francoriba/self_balancing_bot/README.md

# Robot Autobalanceado de Dos Ruedas
Trabajo práctico final de sistemas de control 1 - FCEFyN, UNC - Robot Autobalanceado
Videos y fotos del proyecto: https://drive.google.com/drive/folders/1bMKZYu2w7RBSlc7AJ7NAG8CdF2A5MKAy?usp=sharing
