francoriba/self_balancing_bot/v2.4.0_robot_riba.pdf

# Universidad Nacional de Córdoba Facultad de Ciencias Exactas, Físicas y Naturales Córdoba, Argentina

# Trabajo Integrador de Sistemas de Control 1

# ROBOT DE DOS RUEDAS AUTOBALENCEADO

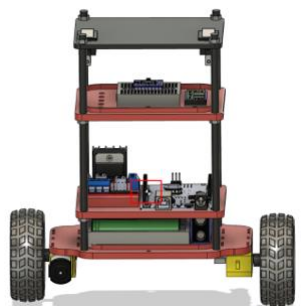
[picture p1: figure]

### Autor: Riba, Franco Docentes: Ing. Claudio Agüero – Ing. Reinado Reyes Contacto: franco.riba@mi.unc.edu.ar Año de cursado de la asignatura: 2021

## ÍNDICE

### Acceso a recursos:

### Repositorio en GitHub del proyecto (código Arduino + simulaciones): https://github.com/francoriba/sisControl/tree/master

Videos | y | fotos | de | la | evolución | del | proyecto:

### https://drive.google.com/drive/folders/1bMKZYu2w7RBSlc7AJ7NAG8CdF2A5MKAy?usp=sh

aring (https://drive.google.com/drive/folders/1bMKZYu2w7RBSlc7AJ7NAG8CdF2A5MKAy?usp=sharing)

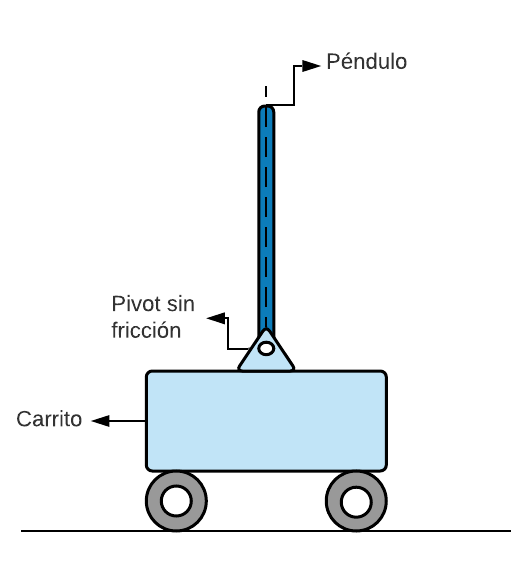
[picture p2: figure]
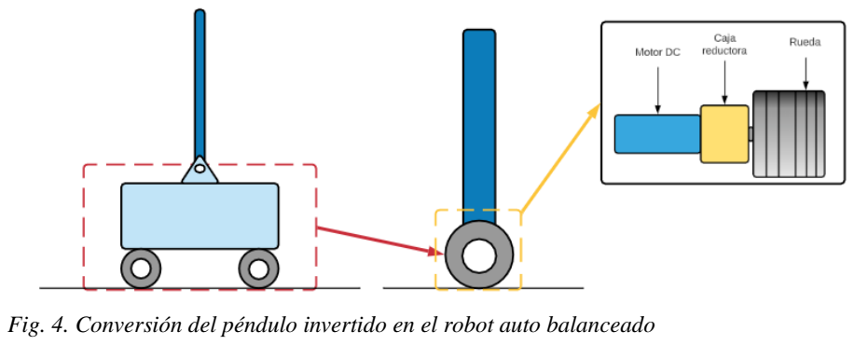
[picture p3: figure]

Córdoba, Argentina, 2022

### 1. Introducción

El robot de dos ruedas auto balanceado consiste en plataforma robótica con dos ruedas que actúan independientemente y un centro de masa que se encuentra sobre el eje de rotación de las ruedas. Este tipo de robots han tenido un rápido avance en la última década y aparecieron en múltiples áreas de la vida cotidiana de las personas. Los ejemplos más notables que hacen uso de los mismos principios son los vehículos de transporte urbano como pueden ser los llamados Segway o los Hoverboards, sin embargo, se pueden hallar multitud de aplicaciones en distintos campos, como los dispositivos de transporte de equipajes, robots de asistencia y sillas de ruedas. Se trata de un proyecto no muy sencillo que engloba la mayoría de los conceptos aprendidos en la materia Sistemas de Control 1 y que da lugar a poner en práctica nuestras capacidades de diseño y programación.

### 2. Definición del Problema

### 2.1 Principio de Funcionamiento

Este sistema basa su funcionamiento en el mismo principio que rige el balanceo del clásico sistema de péndulo invertido con carrito motorizado mostrado en la Fig. 1. En este sistema cuando el péndulo cae hacia adelante el carrito avanza al frente para volver al estado de equilibro como se muestra en la Fig. 2., por el contrario, cuando el péndulo cae hacia atrás, el carrito retrocede con el mismo objetivo como se indica en la Fig. 3.

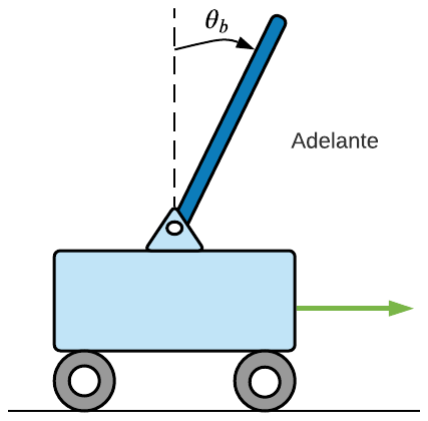
[picture p4: figure]
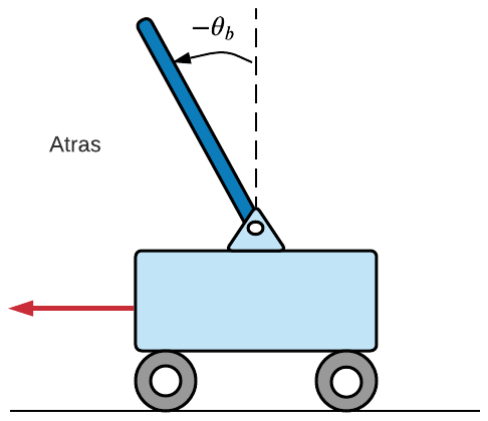
[picture p5: figure]

Podemos transformar fácilmente este sistema en el de del robot auto balanceado reemplazando el carrito por dos motorreductores con escobillas cuyos ejes de salida pasarán a ser pivotes entre las ruedas y el chasis (péndulo).

Fig. 4. Conversión del péndulo invertido en el robot auto balanceado

Fig. 3. Péndulo invertido | Fig. 2. Péndulo invertido en equilibrio
inclinado hacia adelante y
acción restauradora

Fig. 1. Péndulo invertido hacia atrás y acción restauradora

### 2.2 Conceptos Teóricos de Sistemas de Control

Este apartado está dedicado a relacionar y asociar conceptos teóricos básicos de Sistemas de Control con nuestro sistema de estudio.

### 2.2.1 Bloques del Sistema

- Detector de error: implementado vía software mediante placa de desarrollo Arduino UNO.
- Controlador: utilizaremos un controlador digital, concretamente la placa de desarrollo Arduino UNO, a nivel de software el controlador contará con un algoritmo de control PID.
- Amplificador: modulo controlador para motores, doble puente H - L298N.
- Actuador o Accionador: motorreductores genéricos de robótica.
- Planta o Proceso: dinámica del robot autobalenceado propiamente dicho, formado por lo que más adelante en este informe llamaremos Cuerpo Principal y Sistema de Rotación.
- Unidad de realimentación o Captador: sensor tipo IMU (Unidad de Medición Inercial), concretamente el módulo MPU 6050 de 6 ejes que integra un acelerómetro (mide aceleración lineal en 3 ejes), un giroscopio (mide velocidad angular en 3 ejes) y un DMP (Procesador de movimiento digital que permite obtener la fusión de los datos del acelerómetro y del giroscopio independientemente del microcontrolador)

En el anexo podrá encontrar el detalle del hardware utilizado donde se explica con mayor detalle el funcionamiento, características y otros aspectos a considerar de los componentes utilizados.

### 2.2.2 Señales del Sistema y sus Niveles

- Señal de mando o entrada: ángulo de inclinación θbset [°] deseado para el robot. Este parámetro se configura vía software en el microcontrolador.
- Señal controlada o salida: rigurosamente se tienen dos señales de salida, la velocidad angular θ̇
b [

°
seg

]

del chasis del robot (que captará el giroscopio) y aceleración lineal a[

m
s

2

] (que captará el

acelerómetro). Sin embargo, para simplificar el análisis consideraremos directamente al ángulo de inclinación del chasis del robot θb[°]como única señal de salida ya que es esto lo que deseamos controlar.
- Señal de error: diferencia entre el ángulo de inclinación deseado y el ángulo de inclinación calculado por procesador de movimiento digital del MPU6050, esto es e(t) = θbset − θb

(t) [°].
- Señal de control: tensión va

(t)[V] que el amplificador aplica a los motorreductores (señal de alta potencia generada por el driver) en función del ancho de pulso de la señal PWM de 8 bits (señal de baja potencia generada por el controlador) comandada por el algoritmo de compensación PID a implementar en el microcontrolador.
- Señal realimentada: ángulo de inclinación θb(t) detectado (en verdad calculada a partir de los valores de velocidad y aceleración sensados) por el sensor.

NOTA: ver diagrama de bloques del sistema al final del anexo del informe.

### 2.2.3 Posibles Perturbaciones

Las perturbaciones más frecuentes a la que será sometido el sistema son por un lado la propia gravedad y por el otro el dedo humano ya que una vez se tenga el robot funcionando podremos examinar sus limitaciones obstaculizando su funcionamiento en distintos niveles. Otra perturbación de la misma naturaleza podría originarse cuando el robot impacte contra algún objeto ya que no estaremos incorporando al robot un sistema de detección de obstáculos, sin embargo, esto sería posible utilizando sensores ultrasónicos o infrarrojos, aunque quedará pendiente como posible mejora futura del proyecto.

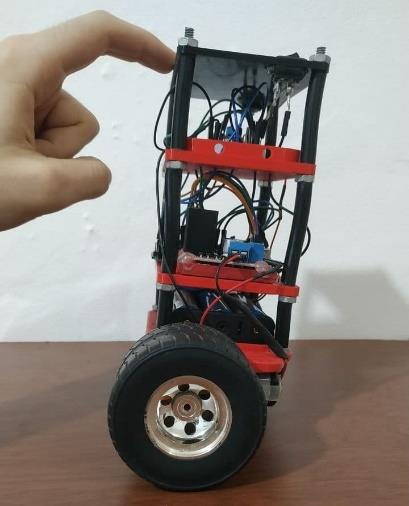
[picture p6: figure]

Otras perturbaciones no tan intuitivas que pueden presentarse podrían ser aquellas relacionadas a la presencia de error y demoras en la estimación de la variable de salida debido a la forma de operación de los sensores y la presencia de ruido. La eficiencia de los algoritmos utilizados también es un aspecto para considerar ya que comúnmente la etapa de censado y realimentación requiere filtros Kalman o filtros complementarios para la obtención de θi

(t), es por esta
razón que para esta tarea se ha optado por utilizar el algoritmo de fusión del DMP integrado al MPU 6050 ya que este utiliza técnicas estadísticas y trabaja con cuaterniones (una extensión de los números reales similar a los números complejos).

### 2.2.4 No Linealidades Involucradas

- Fuerzas de fricción no lineales en el motor y la caja reductora.
- Efectos de saturación en el circuito del controlador L298N que puedan producirse cal alcanzar la máxima corriente permitida.
- No linealidades propias del modelado matemático del cuerpo principal (desarrollado en sección 3.5)

### 3. Modelado Matemático de la Planta

El objetivo final de esta sección es la obtención de la función de transferencia de la planta. Debemos aclarar que basándonos en [https://en.wikipedia.org/wiki/Plant_(control_theory)] en este trabajo se considerará que la planta contempla dos elementos, el primero es el “Actuador” representado por el motorreductor y el segundo es el “Proceso” que para nuestro sistema podría considerarse representado por el conjunto chasis-ruedas. Esto puede diferir de lo indicado en ciertas bibliografías que consideran como elementos separados a los actuadores y a la planta, lo cierto es que en nuestro robot los motorreductores se encuentran rígidamente enlazados al chasis y las ruedas, es por ello por lo que resulta conveniente considerar la planta como sistema que combina los elementos motorreductor, chasis y rueda. Dado que el motorreductor funciona como nexo entre el chasis y las ruedas proponemos dividir la planta en dos subsistemas acoplables entre sí, los subsistemas que proponemos son:

- Cuerpo Principal: este subsistema se asemeja funcionalmente al péndulo en el sistema de péndulo invertido con carrito. Los elementos que incluye son:
✓ | Chasis (plataformas con los componentes y varillas)
✓ | Estator
✓ | Rodamientos/bujes/rulemanes/bolilleros del eje del motor
✓ | Carcasa de motorreductor
- Sistema de Rotación: este subsistema se asemeja al carrito en el sistema de péndulo invertido con carrito. Los elementos que incluye el Sistema de Rotación son:
✓ | Rueda
✓ | Rotor del motor eléctrico
✓ | Engranajes de la caja reductora
✓ | Eje de salida de la caja reductora

La figura representa la división de partes planteada para el robot:

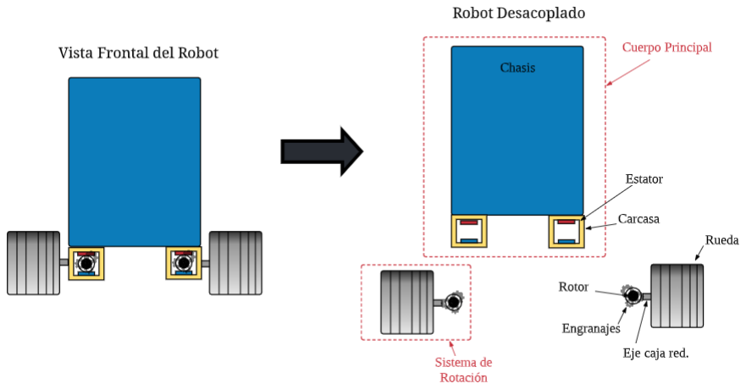
[picture p7: figure]

### 3.1 Consideraciones Previas

En esta sección se dejan en claro todos los detalles que el lector debería tener en consideración antes de iniciar de lleno en la lectura sobre la obtención de las ecuaciones de movimiento del sistema.

### 3.1.1 Nomenclatura Básica Utilizada

Para estudiar el movimiento del robot tendremos que trabajar con diversas variables, algunas de ellas describirán el movimiento de las ruedas (analogía con el carrito según la Fig. 4) mientras que otras describirán el movimiento del chasis (analogía con el péndulo según la Fig. 4), es por ello por lo que en la Tabla 1 establecemos la nomenclatura de estas variables y en la tabla debajo indicamos sus unidades en el sistema internacional junto con una breve descripción del aspecto físico que representa cada una de ellas.

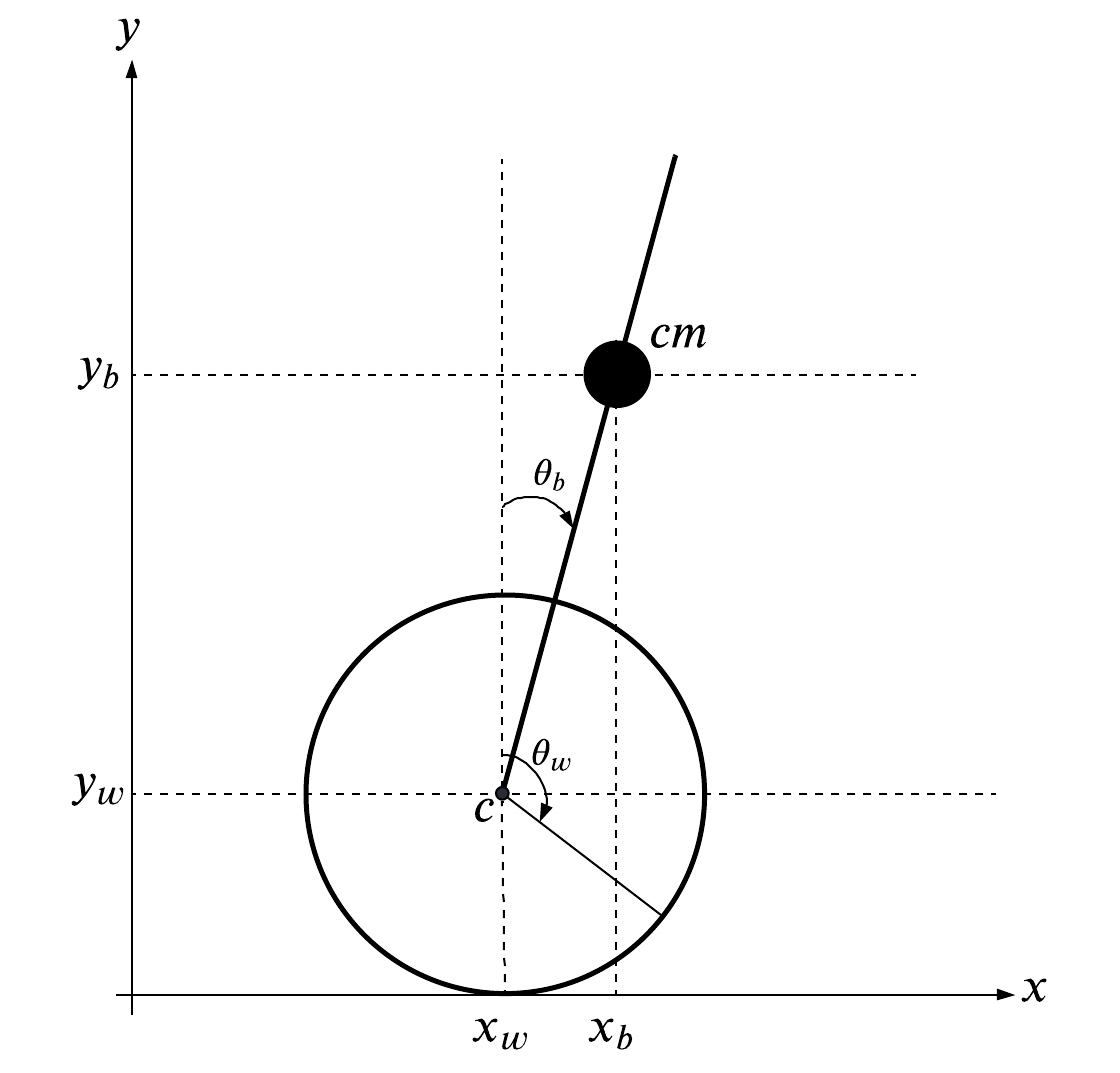
[picture p8: figure]

Símbolo | Unidad | Descripción
θb | θ̇ b | θ̈ b | rad | rad s | rad 2 s | Desplazamiento / Velocidad / Aceleración angular del cuerpo principal
θw | θ̇w | θ̈w | | | | Desplazamiento / Velocidad / Aceleración angular del sistema de rotación
xb | ẋb | ẍb | m | m s | m 2 s | Desplazamiento / Velocidad / Aceleración lineal del centro de masa del cuerpo principal en la dirección x
yb | ẏb | ÿb | | | | Desplazamiento / Velocidad / Aceleración lineal del centro de masa del cuerpo principal en la dirección y
xw | ẋw | ẍw | | | | Desplazamiento / Velocidad / Aceleración lineal del centro de la rueda en la dirección x
yw | ẏw | ÿw | | | | Desplazamiento / Velocidad / Aceleración lineal del centro de la rueda en la dirección y

Tabla 1: Unidades y descripción de las variables que describen el movimiento del Robot

### 3.1.2 Parámetros del Robot

En la figura se indican los distintos parámetros del robot, donde podemos distinguir entre los que son propios del chasis y los que son propios de la rueda.

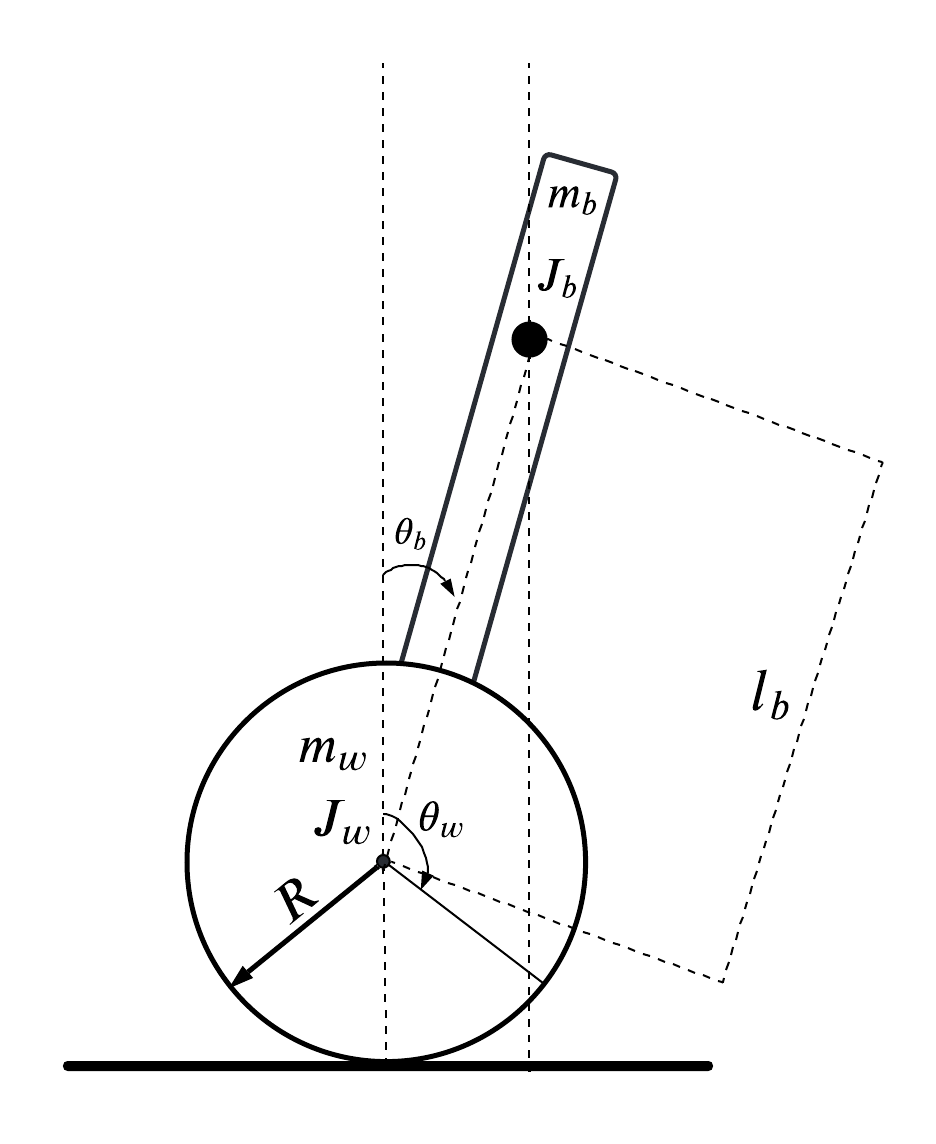
[picture p9: figure]

### 3.1.3 Sistema de Coordenadas Utilizado

A la hora analizar la dinámica del chasis y de las ruedas será útil tener definido un sistema de coordenadas que permita avanzar en el desarrollo de las ecuaciones. La siguiente imagen muestra el análisis realizado al conjunto chasis – ruedas mediante reglas trigonométricas básicas aplicables con la regla SOHCAHTOA, es decir realizando una asociación del sistema del robot con el círculo unitario, esto nos permitirá trabajar con coordenadas polares.

Símb | Uds. | Descripción
mb | Kg | Masa del cuerpo principal
Jb | Kg m² | Momento inercial del cuerpo principal
mw | Kg | Masa del sistema de rotación
Jw | Kg m² | Momento inercial del sistema de rotación
R | m | Radio de la rueda
lb | m | Distancia entre el centro de la rueda y el centro de masa del chasis

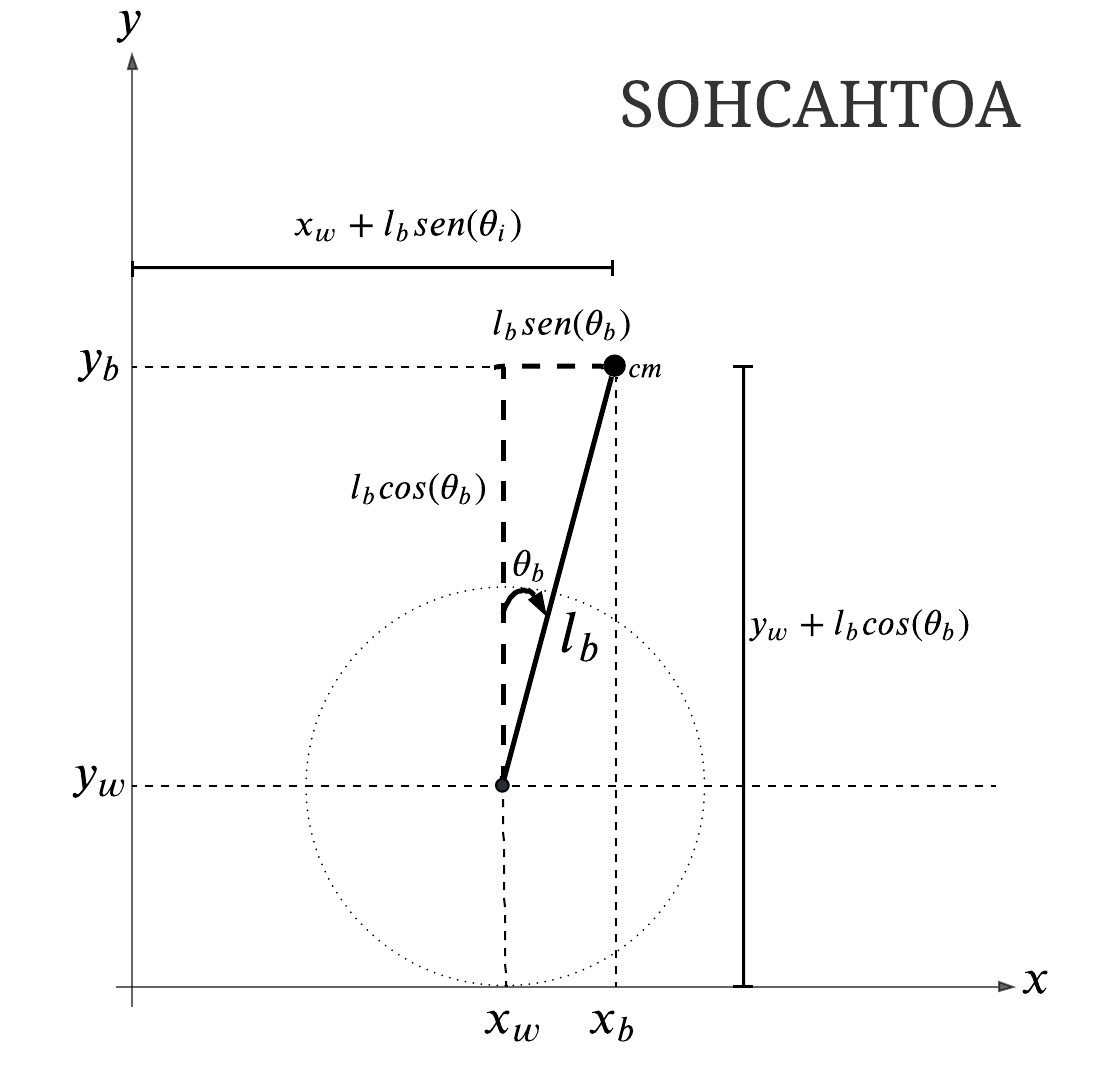
[picture p10: figure]

En base a este análisis podemos observar que el desplazamiento lineal del chasis referenciado a su centro de masa tiene coordenadas cm = (xb, yb) con:

xb = xw + lb sin(θb) | (1)
yb = yw + lb cos (θb) | (2)

Donde xw representa la coordenada en la dirección x del centro de la rueda e yw representa la coordenada en la dirección y de la rueda.

Aplicando las reglas de derivación para el producto de funciones y la regla de la cadena a (1) y (2) obtenemos:

{

ẋb = ẋw + θ̇
blb cos(θb

)
ẍb = ẍw +θ̈
blb cos(θb

)−θ̇
b

2
lb sen(θb

)
ẏb = ẏw − θ̇
blb sen(θb

) = −θ̇
blb sen(θb

)
ÿb = −θ̈
blb sen(θb

)−θ̇
b

2
lb cos(θb

)

(3)

### 3.2 Dinámica del Sistema de Rotación

Recordemos que cuando hablamos de sistema de rotación nos referimos al conjunto rueda-rotor-engranajes-eje.
Para el modelado se asumen las siguientes condiciones:
1. Ambas ruedas son idénticas.
2. Las ruedas son rígidas y de masa uniformemente distribuida.
3. Las ruedas giran sin deslizar.
4. La superficie en que se mueve el robot es plana y horizontal, cumpliéndose que ẏw = 0

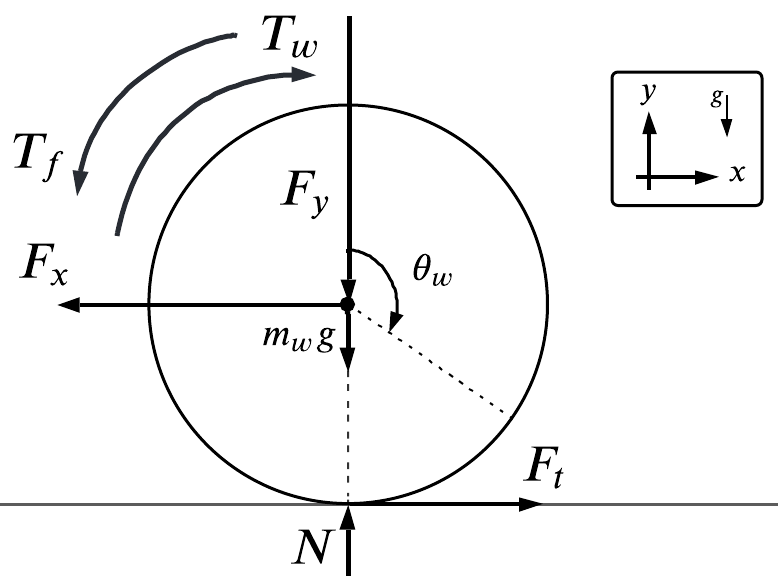
[picture p11: figure]

Como hemos ya hemos establecido al inicio se asume una superficie plana y horizontal de forma que ẏw = 0 y en consecuencia ÿw = 0, teniendo esto en cuenta podemos aplicar la segunda ley de movimiento de Newton a las fuerzas en la dirección y (i.e. ∑ Fy

⃗⃗ = mwÿw) tomando como referencia la Tabla 1:

N − mwg −Fy = mwÿw = 0 | (4)

Haciendo uso de la segunda ley de movimiento de Newton para las fuerzas en la dirección x (i.e. ∑ Fx

⃗ = mwẍ), se
obtiene:
Ft −Fx = mwẍw | (5)

Haciendo uso de la misma ley aplicada a la rotación (i.e. ∑ Mo = Jwθ̈w) ,se obtiene:

Tw − RFt = Jwθ̈w | (6)

Dado que se ha asumido que la rueda gira sin deslizar resulta válido plantear:

xw = θwR → θw =

xw
R

→ θ̈w =

ẍw
R

(7)

Si ahora se despeja Ft de (5) y se la remplaza junto a (7) en (6) se obtiene la expresión:

ẍw (Jw

1
R² + mw ) =

1
R
Tw − Fx | (8)

Esta ecuación nos resultará útil mas adelante.

Símb | Uds. | Descripción
Fx | N | Fuerza horizontal rueda-chasis
Fy | N | Fuerza vertical rueda-chasis
Ft | N | Fuerza de tracción (rozamiento)
mwg | N | Peso del sistema de rotación
N | N | Fuerza normal a la superficie
Tw | N m | Torque aplicado a la rueda
Tf | N m | Torque de fricción (despreciado)

### 3.3 Dinámica del Cuerpo Principal

Hay que recordar que cuando hablamos de cuerpo principal nos referimos al conjunto chasis-estator-carcasa. Para simplificar el modelado se asume que el peso se encuentra uniformemente distribuido.

La única diferencia con las fuerzas externas de la rueda es la ausencia de fuerza de tracción Ft
, esto es debido
a que el eje del motorreductor solo impulsa a la rueda, no al chasis.

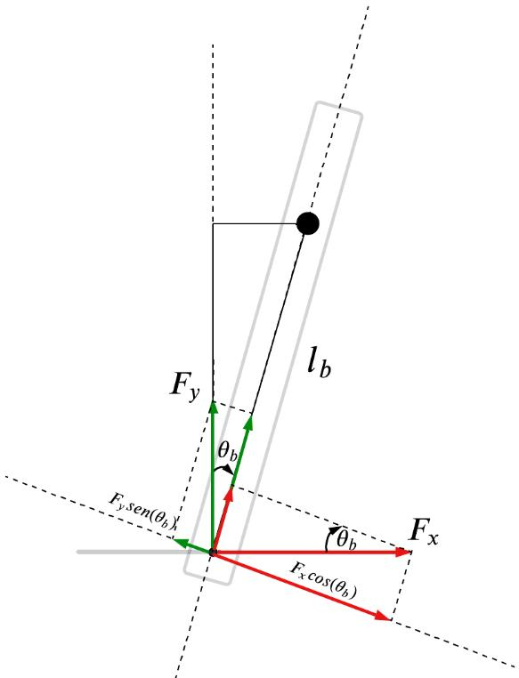
[picture p12: figure]
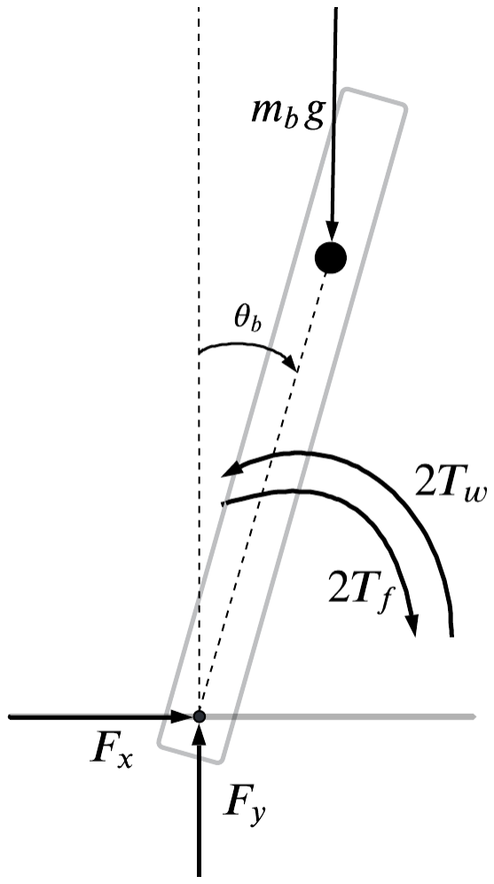
[picture p13: figure]

Consideraremos al giro en sentido horario como negativo y al giro en sentido anti-horario como positivo.

Haciendo uso de la segunda ley de movimiento de Newton en la dirección x (i.e. ∑ Fx

⃗ = mbẍb) , se obtiene:

Fx = mbẍb | (9)

Según los resultados de (3) podemos expresar (9) como:

Fx = mb [ẍw +θ̈
blb cos(θb

)−θ̇
b

2
lb sen(θb
)] | (10)

Haciendo uso de la segunda ley de movimiento de Newton en la dirección y (i.e. ∑ Fy

⃗⃗ = mbÿG) , se obtiene:

Fy − mbg = mbÿb | (11)

Según los resultados de (3) podemos expresar (11) como:

Fy = mbg − mb [θ̈
blb sen(θb

) + θ̇
b

2
lb cos(θb
)] | (12)

Haciendo uso de la segunda ley de movimiento de Newton aplicada a la rotación del centro de masas del chasis (i.e. ∑ Mcm = Jbθ̈
b) ,y teniendo en cuenta la descomposición de fuerzas presentada en 3.3 tenemos que:

−2Tw + Fylb sin(θb

)− Fxlb cos(θb

) = Jbθ̈
b | (13)

### 3.4 Obtención de las Ecuaciones de Movimiento

Sustituyendo (10) y (12) en (13) se obtiene la primer ecuación de movimiento para el conjunto rueda-chasis:

(Jb + mblb

2
)θ̈
b = mbg lb sen(θb

)− mblb cos(θb

) ẍw − 2Tw | (14)

Mientras que si sustituimos (10) en (8) btenemos la segunda ecuación de movimiento para el conjunto rueda-chasis:

[mb +2 (

Jw
R² + mw )] ẍw = −mblb cos(θb ) θ̈
b + mblb sen(θb

) θ̇
b

2
+

2Tw
R | (15)

### 3.5 Linealización de las Ecuaciones de Movimiento

Observando las ecuaciones de movimiento obtenidas podemos darnos cuenta de que no son lineales debido a la presencia de funciones seno, coseno y exponentes cuadráticos. Como ya sabemos, en la asignatura de Sistemas de Control nos hemos enfocado exclusivamente en el estudio de sistemas lineales e invariantes en el tiempo (LTI), por lo que un sistema no lineal necesitará ser linealizado para que podamos avanzar con su estudio. La clave para linealizar nuestras ecuaciones de movimiento es identificar en qué punto el sistema se encuentra en equilibrio ya que en torno a dicho punto existirá una región de operación en la cual puede establecerse una aproximación como sistema lineal de nuestro sistema no lineal.

Resulta intuitivo pensar que el robot se caerá si no es inicialmente colocado en una posición cercana al punto de equilibrio, esto significa que bajo funcionamiento normal el robot deberá encontrarse en una posición aproximadamente vertical respecto de la superficie de apoyo y el movimiento de rotación a lo largo del eje de la rueda será θb ≈ 0 rad, entonces este será el punto de operación que utilizaremos para linealizar nuestro sistema.

Los términos de las ecuaciones de movimientos que deberemos linealizar son sen(θb

), ẍwcos(θb

), θ̈
bcos (θb) y
θ̇
b

2
sen(θb

), para linealizarlos utilizaremos el método de expansión en serie de Taylor considerando el primer término de esta y considerando el punto de operación ya indicado (i.e. punto de operación θi = 0 rad ).

sen(θb

) ≈ θb

ẍwcos(θb

) ≈ ẍw

θ̈
b cos(θb

) ≈ θ̈
b

θ̇
b

2
≈ 0

(16)

Sustituyendo lo planteado en (16) en (14) y (15) obtenemos las ecuaciones de movimiento linealizadas:

(Jb + mblb

2
)θ̈
b = mbg lbθb − mblbẍw −2Tw | (17)

[mb + 2 (

Jw
R² + mw )] ẍw = −mblbθ̈
b +

2Tw
R | (18)

Notar que se han linealizado las ecuaciones de manera previa a combinar las ecuaciones de la dinámica del sistema de rotación y el cuerpo principal con las ecuaciones de la dinámica del actuador, la razón por la que podemos hacer esto es porque de antemano sabemos utilizaremos un modelo lineal del motor, es decir que las ecuaciones que describen su comportamiento no requerirán la linealización de algunos de sus términos.

Las ecuaciones (17) y (18) pueden ser reescritas con el fin de expresarlas en el formato de espacio de estados, para eso sustituimos θ̈
b de (17) en (18) y ẍw de (18) en (17)(14) al hacer esto y reordenar las expresiones resultantes se obtiene:

ẍw =

1

mb+2(

Jw
R2+mw )−

(mblb

)

2

Jb+mblb

2

{−

(mblb)

2g

Jb+mblb

2 θb + 2 [

1
R

+

mblb
Jb+mblb

2

] Tw}

(19)

θ̈
b =

1

Jb+mblb

2−

(mblb

)

2

mb+2(

Jw
R2

+mw )

{mblbgθb − 2 [R +
mblb
mb+2(

Jw
R2+mw )

]
Tw
R

}

(20)

Definiendo las constantes:

M ≡ mb + 2 (

Jw
R² + mw ) −

(mblb)

2

Jb+mblb

2

J ≡ Jb + mblb

2 −

(mblb)

2
mb+2(

Jw
R2+mw )

C1 ≡ −

1
M

(mblb)

2g

Jb+mblb

2

C2 ≡

2
M

[

mblb
Jb+mblb

2 +

1
R

]

C3 ≡

1
J

mb lbg

C4 ≡ −

2

RJ (
mblb
mb+2(

Jw
R2+mw )

+ R)

(21)

Las ecuaciones (19) y (20) pueden ser expresadas como:

ẍw = C1θb + C2Tw

θ̈
b = C3θb + C4Tw

(22)

### 3.6 Dinámica del Actuador

Los actuadores que se implementarán en el sistema son motorreductores, es decir motores DC con escobillas a los cuales se les adiciona una caja reductora con engranajes que permiten aumentar la cantidad de toque producido por el motor a costa de una disminución proporcional de la velocidad de giro del eje de salida de la caja reductora respecto de la velocidad de giro del eje motor. En la siguiente imagen se indican las partes básicas por las que se encuentra formado un motorreductor.

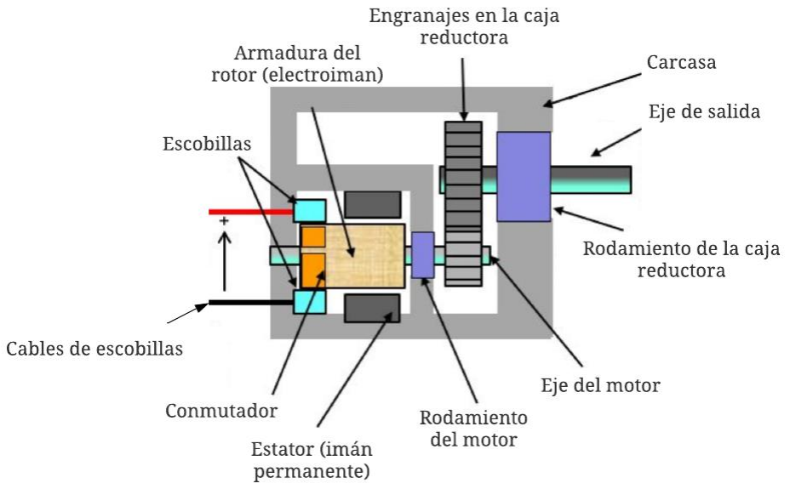
[picture p14: figure]

Antes de comenzar con el modelado del motorreductor se presenta la tabla, la cual indica la simbología que se utilizará para representar los parámetros del motorreductor, así como también indicará las unidades en el sistema internacional y una breve descripción de dichos parámetros.

Símb | Uds. | Descripción
θm | rad | Posición angular del eje del motor
θ̇m | rad/s | Velocidad angular del eje del motor
bf | Nms/rad | Coeficiente de amortiguamiento viscoso del rotor (despreciado)
n | - | Relación de transmisión
Tm | Nm | Torque producido por el motor
va | V | Voltaje de entrada del motor
vemf | V | Voltaje de contra fuerza electromotriz
ia | A | Corriente en la armadura del rotor
Ra | Ω | Resistencia del motor
La | H | Inductancia de la armadura (despreciada)
ke | Vseg/rad | Constante de contra fuerza electromotriz de la armadura
kt | Nm/A | Constante de torque del motor

Para el modelado del motor DC nos resulta de utilidad trabajar con el circuito eléctrico equivalente del rotor que se muestra en la imagen a continuación. El circuito equivalente de las bobinas en el rotor es representado por la conexión en serie de Ra y La. Ra representa la perdida resistiva en la bobina mientras que La representa la autoinductancia del bobinado (el bobinado genera su propio campo magnético cuando se aplica tensión en los terminales del motor, por ello se comporta como un inductor). Cuando se aplica el voltaje vm entre los terminales del motor, la corriente im fluye hacia el bobinado del rotor, entonces este se convierte en un electroimán e interactúa con los imanes permanentes en el estator para impulsar el rotor en sentido horario o antihorario. Los parámetros kt y ke son coeficientes que dependen de la construcción del motor DC.

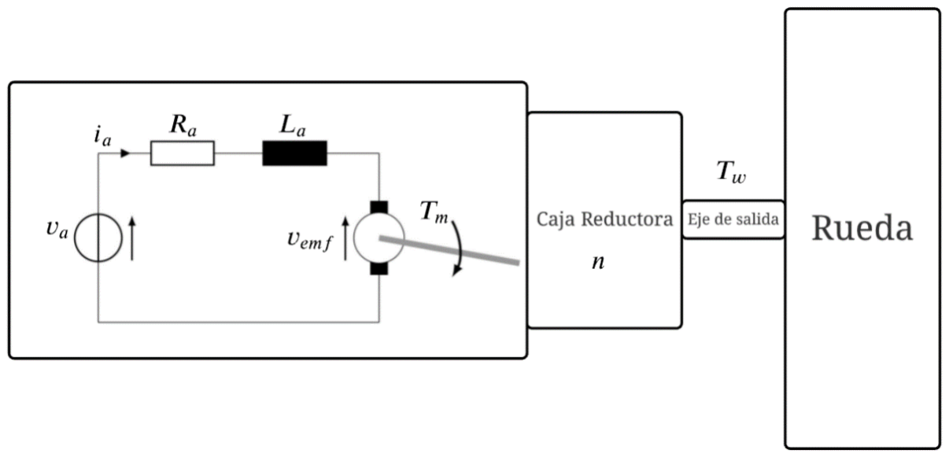
[picture p15: figure]

Se considera el circuito de la armadura en esta imagen, donde el torque generado en el rotor (y posteriormente amplificado por la caja de transmisión y presentado en el eje de salida) es proporcional a la intensidad del campo magnético de la bobina del rotor que a su vez depende de la corriente ia que fluye por la bobina (Ley de Biot-Savart de magnetostática). Este conjunto de relaciones se puede plasmar matemáticamente por medio de la fórmula:

Tm = kt

ia | (23)

Otra relación de los motores DC es la que indica que la tensión de contra fuerza electromotriz dependerá de que tan rápido el rotor gire en torno al estator:

vemf = keθ̇m | (24)

Aplicando la ley de tensiones de Kirchoff al circuito de la armadura se tiene:

va = Raia +

d ia
dt La + vemf | (25)

Sin embargo, la inductancia del motor Lm se considera nula, esto se debe a que cuando el motor se encuentra en reposo la bobina se ha descargado completamente a través del circuito cerrado posteriormente a la anterior marcha del motor. Otra razón para considerar despreciable Lm es que generalmente su valor es muy pequeño comparado con el valor resistivo de Rm. Entonces tenemos que

va ≅ Raia + vemf | (26)

Sustituyendo (24) en (26):

va ≅ Raia + keθ̇m | (27)

Despejando ia de (27) se tiene:

ia ≅

va
Ra

−

keθ̇m
Ra

(28)

Teniendo en cuenta que hemos asumido bf = 0 se cumplen las siguientes relaciones debidas a la presencia de la caja reductora entre la rueda y el motor

Tw = nTm → Tm =

Tw
n | (29)
θm = nθw | (30)

Si ahora sustituimos (28) en (23):

Tm =

kt
Ra

va −

ktke
Ra
θ̇m | (31)

Sustituyendo (29) en (31):

Tw =

nkt
Ra

va −

nktke
Ra

θ̇m
(32)

La ecuación (32) es válida si se asume que la carcasa del motor se encuentra en reposo, sin embargo los motorreductores estan rigidamente fijos al chasis, y θm es el ángulo relativo entre el eje del motor (o rotor) y el estator, por lo tanto deberemos considerar este detalle realizando la modificación θ̇m → (θ̇m −θ̇
b) en (32), de forma que
resulta:

Tw =

nkt
Ra

va−

nktke
Ra

θ̇m +

nktke
Ra

θ̇
b | (33)

Finalmente, si recordamos (7), podemos reemplazar θ̇m por

ẋw
Rn

resultando:

Tw =

nkt
Ra

va −

ktke
RaR

ẋw+

nktke
Ra

θ̇
b | (34)

Y definimos las siguientes constantes del motor:

Cm1 ≡

nkt
Ra
Cm2 ≡ −

ktke
RaR
Cm3 =

nktke
Ra

(35)

De forma que podemos expresar (34) como

Tw = Cm1va + Cm2ẋw + Cm3θ̇
b

(36)

### 3.7 Incorporación de la Dinámica del Actuador a las EDM

Sustituyendo (36) en las expresiones de (22) obtenemos:

ẍw = C1θb + C2Cm1va +C2Cm2ẋw + C2Cm3θ̇
b

θ̈

b = C3θb + C4Cm1va + C4Cm2ẋw + C4Cm3θ̇
b

(37)

### 3.8 Función de Transferencia

Respecto de esta cuestión la asignatura Sistemas de Control 1 ha presentado su foco principal en la obtención de funciones de transferencia utilizando como herramienta la transformada de Laplace ya que esta nos permite tratar ecuaciones diferenciales que describen el comportamiento de un sistema como simples ecuaciones algebraicas que resultan fáciles de manipular.

### 3.8.1 Modelado en Espacio de Estados

Aquí hemos decidido optar por utilizar no solo la transformada de Laplace como herramienta, sino también la representación en espacio de estados para la cual podemos distinguir entre tres tipos de variables:

- Variables de entrada: aquellas que proveen las excitaciones necesarias para el funcionamiento del sistema.
- Variables de estado: aquellas que evolucionan en el tiempo dependiendo de su estado actual y de los valores impuestos a las variables de entrada.
- Variables de salida: aquellas sobre las cuales se quiere tener control.

La representación es espacio de estados resulta especialmente útil cuando deseamos estudiar el comportamiento de sistemas del tipo MIMO (Multiple-input Multiple-output), es decir sistemas que tienen mas de una entrada y/o salida, sin embargo, también existen los sistemas del tipo SISO (single-input single output), es decir sistemas que solo tienen una entrada y una salida. En nuestro caso, el sistema del robot auto – balanceado puede plantearse tanto como sistema MIMO o como sistema SISO dependiendo del nivel de detalle y control que se quiera lograr para el sistema. En principio, optaremos por pensar a nuestro sistema como SISO donde la variable de entrada es la tensión vm aplicada a los motorreductores y la variable de salida es el ángulo de inclinación del robot, sin embargo, la razón por la que se utilizará la representación en espacio de estados es que durante el curso no se puedo dar demasiada profundidad a este tema en concreto y resulta un reto interesante para este trabajo.

Para expresar el modelado del Robot en el espacio de estados debemos determinar la ecuación de estado y la ecuación de salida las cuales se expresan en su versión mas general como:

ẋ = Ax +Bu
y = Cx + Du | (38)

En (38) A es la matriz de control o matriz del sistema, B es la matriz de entrada, C la matriz de salida y D es la matriz de transmisión directa, es una matriz que indica un acoplamiento directo entrada-salida. Por su parte ẋ es lo que se denomina vector de estado, mientras que y es el vector de salidas y u es la variable de entrada. Para nuestro robot visto como sistema SISO la variable de entrada es la tensión de vm aplicada a los motorreductores y la variable de salida es el ángulo de inclinación del chasis θb.

Podemos relacionar (37) con (38) especificando la parametrización de las variables de estado:

Variables de estado:
- Posición horizontal del Robot (en el eje x): x1 = xw
- Velocidad lineal del Robot (en el eje x): x2 = ẋw
- Posición angular del Cuerpo Principal (ángulo de cabeceo del robot): x3 = θb
- Velocidad angular del Cuerpo Principal (velocidad de cabeceo del robot): x4 = θ̇ b

Vector de estado: x = [

x1
x2
x3
x4

] = [

xw
ẋw
θb
θb

̇

]

Derivada del vector de estado: ẋ = [

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
Matriz del sistema o de estado: A = [

0 | 1 | 0 | 0
0 C2Cm2 | C1 | C2Cm3
0 | 0 | 0 | 1
0 C4Cm2 | C3 | C4Cm3

]

Matriz de entrada: B = [

0
C2Cm1
0
C4Cm1

]

Matriz de salida: C = [0 0 1 0]

Matriz de transmisión directa: 0

Entrada: u = va

Salida: y = θb

Combinando toda esta información podemos expresar a nuestro sistema matricialmente, ya sea en el dominio temporal o en el dominio de Laplace, de la siguiente manera:
[

ẋ1
ẋ2
ẋ3
ẋ4

] = [

0 | 1 | 0 | 0
0 C2Cm2 | C1 | C2Cm3
0 | 0 | 0 | 1
0 C4Cm2 | C3 | C4Cm3

] [

x1
x2
x3
x4

] + [

0
C2Cm1
0
C4Cm1

] u(t)
ℒ

→ s [

X1
sX2
X3
sX4

] = [

0 | 1 | 0 | 0
0 C2Cm2 | C1 | C2Cm3
0 | 0 | 0 | 1
0 C4Cm2 | C3 | C4Cm3

] [

X1
sX2
X3
sX4

] + [

0
C2Cm1
0
C4Cm1

]U(s) (39)

O su equivalente si se prefiere no utilizar las variables de estado paramétricas:

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
0 | 1 | 0 | 0
0 C2Cm2 | C1 | C2Cm3
0 | 0 | 0 | 1
0 C4Cm2 | C3 | C4Cm3

] [

xw
ẋw
θb
θb

̇

] + [

0
C2Cm1
0
C4Cm1

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
0 | 1 | 0 | 0
0 C2Cm2 | C1 | C2Cm3
0 | 0 | 0 | 1
0 C4Cm2 | C3 | C4Cm3

] [

X
sX
Θb
sΘb

] + [

0
C2Cm1
0
C4Cm1
]Va | (40)

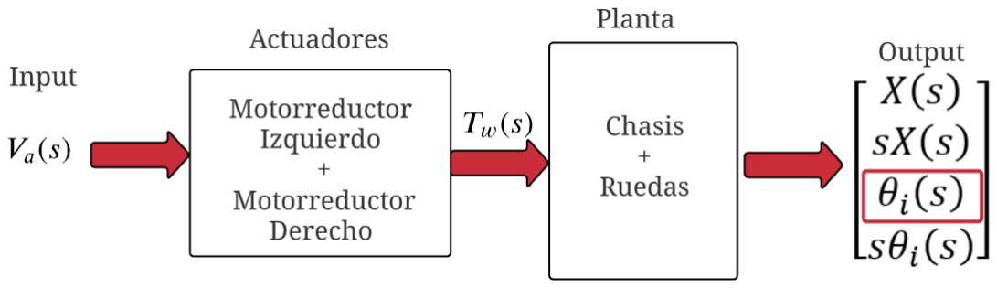
[picture p16: figure]

### 3.8.2 Obtención de la FTLA

Llegados a este punto nos encontramos en condiciones de hallar la función de transferencia para nuestro sistema considerando como entrada la tensión suministrada al motorreductor y como salida el ángulo de inclinación del chasis de nuestro robot.

Para hallar la función de transferencia podemos utilizar la fórmula:

G(s) =

Y(s)
U(s)

= C(sI − A)

−1B + D | (41)

Esta es fácilmente deducible a partir de (38) si se está familiarizado con el álgebra matricial.

Utilizando Matlab para hallar la función de transferencia se obtiene:

Θb(s)
Va(s)

=

−C4Cm1s
−s

3+(C2Cm2+C4Cm3
)s

2+C3s+C1C4Cm2−C2C3Cm2

=

−90s
(s+475)(s+5.7)(s−5.7) | (42)

El resultado de (42) puede comprobarse en Matlab con el código “FT_simbolica.m” mientras que la expresión numérica puede comprobarse con el código “FT_numerica.m”. En caso de que el lector quiera verificar manualmente la función de transferencia numérica presentaremos a continuación los parámetros necesarios para calcular las distintas constantes definidas en (21) y (35).

Parámetros dados de los motorreductores (puede ver la hoja de datos en el anexo)

Parámetro | Variable en Matlab | Valor | Unidad
Torque máximo | Tstall | 0.011 | Kg m
Corriente máxima | Istall | 1.5 | A
Corriente sin carga | Inl | 0.06 | A
Velocidad sin carga | RPMno load | 230 | RPM
Tensión nominal | Vin | 6 | V
Relación de reducción | n | 48:1 | -

Parámetros calculados de los motorreductores

Parámetro | Variable en Matlab | Valor | Unidad
Resistencia de armadura | Ra | Vin = 4 Istall | Ω
Velocidad sin carga | wnl | RPMno load2π 60 = 24.09 | rad
Constante de torque | kt | Tstall Ra = 1.53e − 4 Vinn | Nm A
Constante de contra emf | ke | Vin −RaInl = 0.005 wnln | s V rad

Parámetros del sistema de rotación (valores utilizados justificados en)

Parámetro | Variable en Matlab | Valor | Unidad
Radio de la rueda | R | 0.035 | m
Radio considerado del rotor | r | 0.005 | m
Masa de la rueda | m_rueda | 0.0551 | Kg
Masa del rotor | m_rot | 0.007 | Kg
Masa de engranajes y eje | m_engranajesYeje | 0.0025 | Kg
Masa del sistema de rotación (suma de los 3 anteriores) | mw | 0.0646 | Kg
Inercia de la rueda | Jrueda = 0.5 ∗ m_rueda ∗ R 2 | 3.3749e − 5 | Kg m²
Inercia del rotor | 2 Jrot = 0.5 ∗ mrot ∗ r | 8.75e − 8 | Kg m²
Inercia del sistema de rotación (suma de los 2 anteriores) | Jw | 3.3836e − 5 | Kg m²

Parámetros del Cuerpo Principal

Parámetro | Variable en Matlab | Valor | Unidad
Masa del chasis | m_cℎasis | 0.5584 | Kg
Masa del estator | m_estator | 0.01 | Kg
Masa de la carcasa | m_carcasa | 0.0054 | Kg
Masa del cuerpo principal (Suma de las 3 anteriores) | mb | 0.5738 | Kg
Distancia del centro de la rueda al centro de masa | lb | 0.07 | m
Inercia del cuerpo principal | Jb | 0.0024 | Kgm²

### 3.8.3 Estudio de Estabilidad Absoluta (LA)

Resulta lógico pensar que a lazo abierto nuestro robot no representa a un sistema estable ya que este nunca mantendrá el equilibrio por sí mismo (es decir sin acción de control) sino que se caería constantemente, significando esto que, en términos de estabilidad absoluta, nuestro sistema es inestable.

De lo estudiado en la materia sabemos que, dada una función de transferencia, si el polinomio denominador no está completo o si existen cambios de signo en sus coeficientes el sistema es inestable.

Entonces podemos comprobar rápidamente nuestra hipótesis inicial observando el polinomio denominador de (42), donde podemos ver que, si bien el polinomio está completo, se presenta un cambio de signo, esto confirma que la dinámica de la planta representa a un sistema inestable.

Una forma quizás más directa de probar lo mismo es obtener los polos del polinomio denominador que, con la ayuda de la función pole() de Matlab se puede verificar que son:

p1 = 475

p2 = 5.7

p3 = −5.7

Tambien podemos visualizar esto en un diagrama de ceros y polos utilizando la función pzmap () disponible en Matlab.

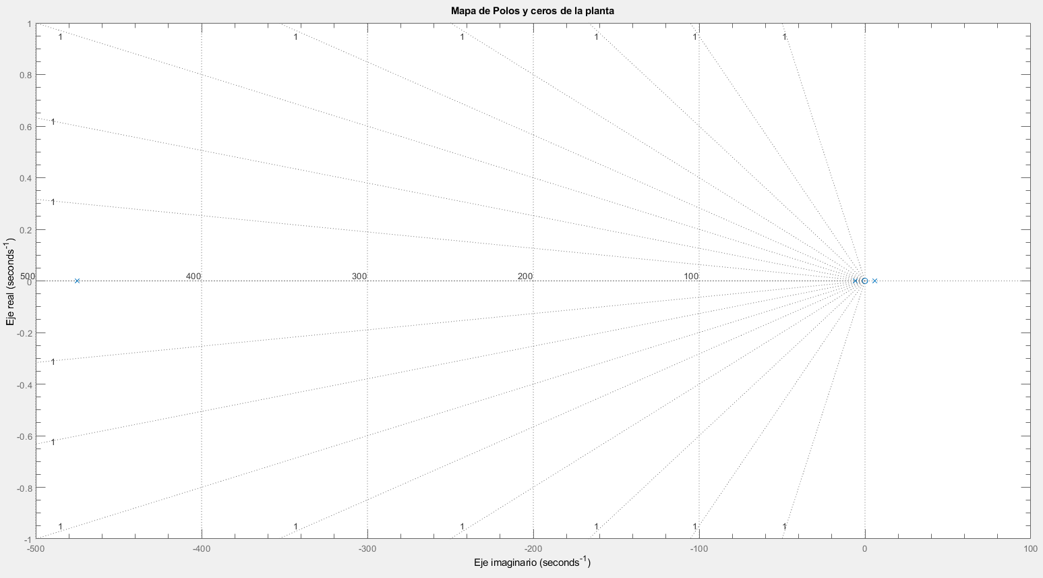
[picture p17: figure]

Como se puede ver existen dos polos en el semi eje real positivo, lo cual nuevamente indica la inestabilidad de la planta.

Alternativamente podemos utilizar la función step() para ver cuál es la respuesta de nuestro sistema frente a una entrada del tipo escalón, hacer esto sería equivalente a ver que sucede con el ángulo de inclinación del robot cuando aplicamos una tensión constante de, por ejemplo, 3V a los motores.

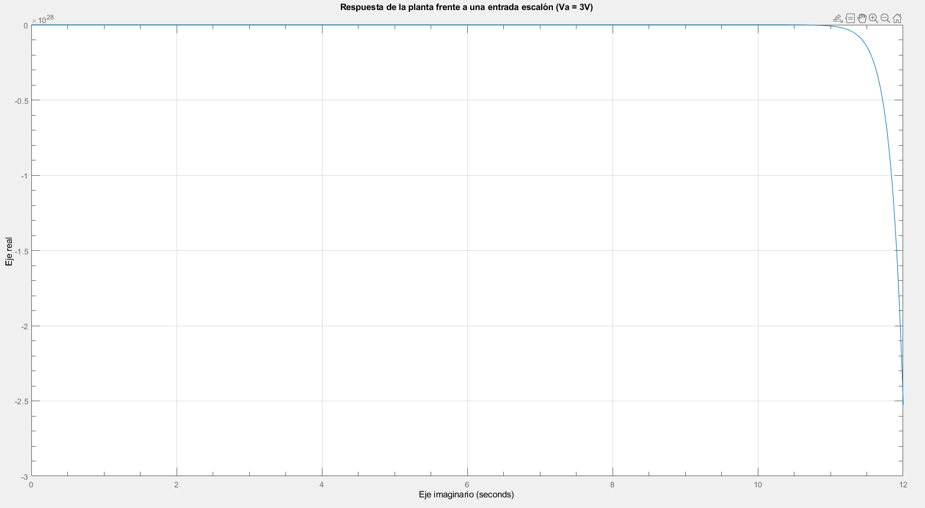
[picture p18: figure]

Como se puede observar en la figura, cuando utilizamos una entrada del tipo escalón, la respuesta del sistema decrece infinitamente indicando la inestabilidad del sistema. Los mismos sucede si en vez de una entrada del tipo escalón de utiliza un impulso. Todos los gráficos y funciones presentados en Matlab se pueden revisar mediante el programa “FT_ numerica.m”.

### 4. Especificaciones de Diseño

En esta sección se definen las especificaciones de diseño en el dominio del tiempo, buscaremos definir los valores deseados de error en estado estable, sobre pasamiento máximo y tiempo de establecimiento para el sistema.

### 4.1 Error en Estado Estable

Para que el robot sea capaz de mantener el equilibrio será de vital importancia eliminar el error en estado estable, esto es ess = 0.

### 4.2 Sobre Pasamiento Máximo

Es deseable minimizar al máximo el sobrepaso del sistema durante la respuesta transitoria. Definiremos entonces el máximo sobrepaso aceptable para el correcto funcionamiento del robot.

En primer lugar, debemos notar el sobrepaso Mp estará dado en [°] ya que la variable de salida del sistema que se desea controlar es el ángulo de inclinación θi

El valor de Mp seleccionado deberá garantizar el funcionamiento del sistema, es decir deberá permitir que el robot sea capaz de volver al estado de equilibrio cuando se encuentra inclinado.

La capacidad del robot de recuperar su estado de equilibrio dependerá básicamente de que el torque aplicado por los motorreductores en un momento dado sea suficiente para contrarrestar la tendencia a caerse que tenga el robot en ese instante.

El torque necesario para que el robot recupere el equilibrio estará dado por:

Treq = mglsen(θi)

Los motorreductores utilizados serán capaces de proporcionar un determinado torque Tstall

Tanto la masa m y la distancia l desde eje de los motores al centro de masa como la gravedad g serán constantes que dependerán del robot construido, por lo tanto, podemos decir que si se dispone de motores capaces de ejercer un torque máximo Tstall, el máximo valor de inclinación permitido para que el robot pueda recuperarse estará dado por:

θimax = sin⁻¹
(

Tstall
mgl )

El sobre pasamiento máximo Mp vendrá dado por la diferencia entre el ángulo de inclinación deseado y el máximo ángulo de inclinación con el que los motores pueden lidiar.

Mp =

|θiset −θimax|

θiset

O bien:

Mp

(%) =

|θiset − θimax|

θiset

∗ 100

Un valor de sobrepaso mayor a este tendrá como resultado la caída del robot.

### 5. Diseño del Controlador

En esta sección buscaremos estabilizar la FT dada por la señal de entrada (voltaje del motor va(s)) y la señal de salida (ángulo de inclinación del cuerpo del robot θi

### 5.1 Marco Teórico 5.1.1 Acción de control P

La acción proporcional busca que el error disminuya lo más rápido posible, normalmente a mayor Kp más rápido se minimiza el error, pero aumentarlo demasiado puede traer consecuencias negativas, como por ejemplo el aumento de las oscilaciones a la salida, es decir que el sistema se vuelva sub amortiguado, lo cual implicaría un tiempo de establecimiento mayor, y también podríamos ocasionar que el sistema salga de la zona de trabajo lineal.

Cuando se implementa una acción de control proporcional:

u(t) = Kpe(t)

U(s) = KpE(s)

U(s)
E(s)

= P(s) = Kp

### 5.1.2 Acción de control PI

En este caso se agrega una acción integral que se encarga de la acumulación del error a lo largo del tiempo, la acción integral no solo se basa en el valor actual del error, sino también en todos sus valores pasados y sumado a esto añade un polo en el origen al sistema, es decir aumenta en uno el orden del sistema. En conclusión, la acción proporcional busca minimizar rápidamente el error, mientras que la acción integral busca hacer nulo el error, tanto para frente a cambios en la entrada del sistema como frente a perturbaciones externas. Agregar la acción integral no aumentará el sobre pasamiento, pero si puede aumentar el tiempo de establecimiento ya que al poner un polo en el origen se acercan las raíces de la ecuación característica al eje imaginario.

u(t) = Kp (e(t)+
1
Ti

∫ e(τ)dt

t

0

) = Kpe(t) + Ki ∫ e(τ)dt

t

0
U(s) = Kp (E(s)+

E(s)
Tis

) = Kp (1 +
1
Tis

) E(s)

U(s)
E(s)

= PI(s) = Kp (1 +

1
Tis

) = Kp +

Ki
s

=

Kp (s +

Ki
Kp

)

s

De esta última fórmula vemos que un controlador PI se traduce en la presencia adicional de un cero ubicado en −

Ki
Kp
y un polo en el origen, de forma que mediante las constantes Ki y Kp podemos mover el cero real y cambiar la ganancia general del sistema.

### 5.1.3 Acción de control PD

En este caso, al agregar la acción derivativa la salida del controlador pasara a ser proporcional a la razón de cambio de la señal de error respecto del tiempo, esto quiere decir que, si el error es constante, la acción derivativa es nula, es decir que la acción derivativa solo toma efecto durante los transitorios y cuando se producen perturbaciones. La acción derivativa busca minimizar los sobre pasamientos que se producen cuando la acción proporcional es muy alta, esto es posible ya que la acción derivativa se anticipa al estado futuro del sistema.

u(t) = Kp (e(t) + Td

de(t)
dt ) = Kp e(t) + Kd

de(t)
dt

U(s) = Kp(E(s)+s TdE(s)) = Kp (1 + Tds)E(s)

U(s)
E(s)

= PD(s) = Kp

(1 +Tds) = Kp + Kds

### 5.1.4 Acción de control PID

Combinando las tres leyes de control anteriores, podemos esperar que se produzca un rápido rechazo de las perturbaciones y la tendencia a hacer nulo el error en estado estable tanto por cambios en la entrada como por perturbaciones (acción integral), además por la acción proporcional esa tendencia deberá suceder rápidamente, por último, la acción derivativa actuará durante los transitorios para minimizar posibles oscilaciones ocasionados por un alto valor de Kp .

u(t) = Kp (e(t)+
1
Ti

∫ e(τ)dt + Td

de(t)
dt

t

0

) = Kp e(t) + Ki ∫ e(τ)dt + Kd de(t)
dt

t

0
U(s) = Kp (E(s) +
E(s)
Tis

+s TdE(s)) = Kp (1+
1
Tis

+ Tds) E(s) = Kp (
TdTis

2 + Tis + 1
Tis

) E(s)

U(s)
E(s)

= C(s) = Kp (
TdTis

2 + Tis + 1
Tis

) =
Kds

2 + Kps + Ki
s

### 5.2 Diseño

Comenzamos analizando el grafico del lugar de raíces del sistema (sin control PID):

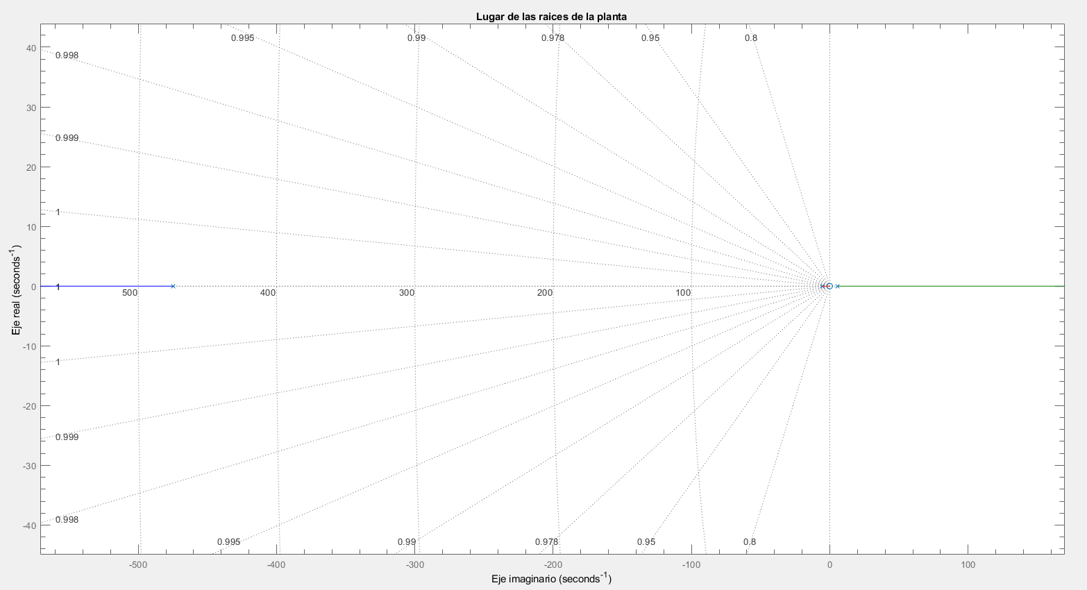
[picture p19: figure]

Podemos apreciar que tal como ya habíamos anticipado, el grafico del lugar de raíces pone en evidencia nuevamente la inestabilidad de la planta sin controlar, una función de transferencia inestable causará que el control del robot falle. Es por ello por lo que diseñaremos a continuación un control PID, basándonos en los fundamentos teóricos ya mostrados en el marco teórico de esta sección. Del gráfico del lugar de raíces también podemos observar que no existe un camino entre los polos y el cero, esto significa que no existe ningun valor de ganancia proporcional Kp que pueda estabilizar el sistema por sí misma, siendo esto otra de las razones por las que no solo resulta conveniente, sino también necesario optar por un control PID.

El método de diseño utilizado será el de “ubicación de los polos”. La estabilidad se alcanza logrando que el polo inestable en +5.7 sea cancelado y colocado un nuevo polo convenientemente en el medio entre el origen y el polo estable en -5.7, en este caso buscaremos ubicar este nuevo polo en -3, donde es de esperar que no se genere interferencia con la dinámica del sistema por estar demasiado cercano al origen y, por lo tanto al eje imaginario y el plano inestable (semi plano derecho) y no demasiado cerca a otro polo que también podría interferir los efectos positivos del polo dominante generando la no amortiguación del sistema. Según hemos investigado, en teoría, podríamos mover el polo aún más lejos del origen para una mejor respuesta del sistema, sin embargo, si esto es llevado al extremo podría causar mucho estrés en los actuadores llevándolos a un punto de ruptura.

Teniendo en cuenta que nuestra FT es de la forma:

G(s) =

ks
(s −p1)(s −p2)(s − p3)

Combinando esta ecuación con la obtenida en el marco teórico para la acción de control PID:

P(s) =

G ∗ (s)C(s)
1+ G(s) ∗ C(s)

=

ks(Kds

2 + Kps +Ki)
ks(Kds

2 + Kps + Ki)+ s(s − p1)(s −p2)(s − p3)

=

kKds

3 +kKps

2 + kKis
kKds

3 + kKps

2 +kKis +s(s

3 − s

2(p1 + p2 + p3
)+ s(p1p2 + p1p3 + p2p3

)− p1p2p3)

=

kKds

3 + kKps

2 +kKis
s(s
3 + s

2(−p1−p2 − p3 + kKd

)) + s(p1p2 + p1p3 + p2p3 + kKp) + (−p1p2p3 + kKi))

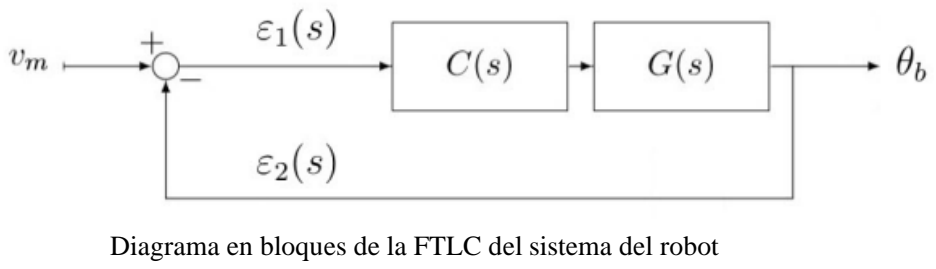
[picture p20: figure]

Ahora el objetivo es obtener un denominador de la forma:

s(s − p

′
1

)(s −p

′
2

)(s − p

′
3

) = s(s − p1
)(s −p2

)(s − p

′
3

) = s(s − 475)(s − 5.7)(s − 3)

La razón de esto es que la nueva función de transferencia diseñada con PID tiene que ser equivalente a la anteriormente planeada en (42) con la diferencia de que un polo positivo es “intercambiado” por un polo negativo.

Con esta lógica tenemos entonces que:
{
−p1−p2 −p3 + kKd = −p1−p2 − p′3 p1p2 + p1p3 + p2p3 + kKp = p1p2 +p1p′3 + p2p′3 −p1p2p3 + kKi = −p1p2p′3

Resultando así:

{

Kp =

p1p′3 +p2p′3 − p1p3 +p2p3
k

KI =

p1p2p3 + p1p2p′3
k

KD =

p3 −p′3
k

Reemplazando los valores de los polos y de la ganancia obtenemos:
{
Kp = −46.5603
KI = −260.2962
KD = −0.0969

Esto ha sido una aproximación teórica a los valores de las constantes que deberíamos utilizar para lograr la estabilidad del sistema mediante un control PID, sin embargo según se ha investigado, para realizar la validación del modelo sería necesario convertir el control PID al dominio discreto, este tema no ha sido cubierto durante la cursada, por lo tanto se lo considera fuera del alcance del curso de sistemas de control 1, de hecho toda la implementación del control PID en tiempo continuo fue investigada y aprendida por cuenta propia, ya que durante la cursada no se alzan a cubrir estos contenidos. Por estas razones la validación final del sistema físico construido será mediante “prueba y error” en la programación de la constante de control PID.

Diagrama en bloques de la FTLC del sistema del robot

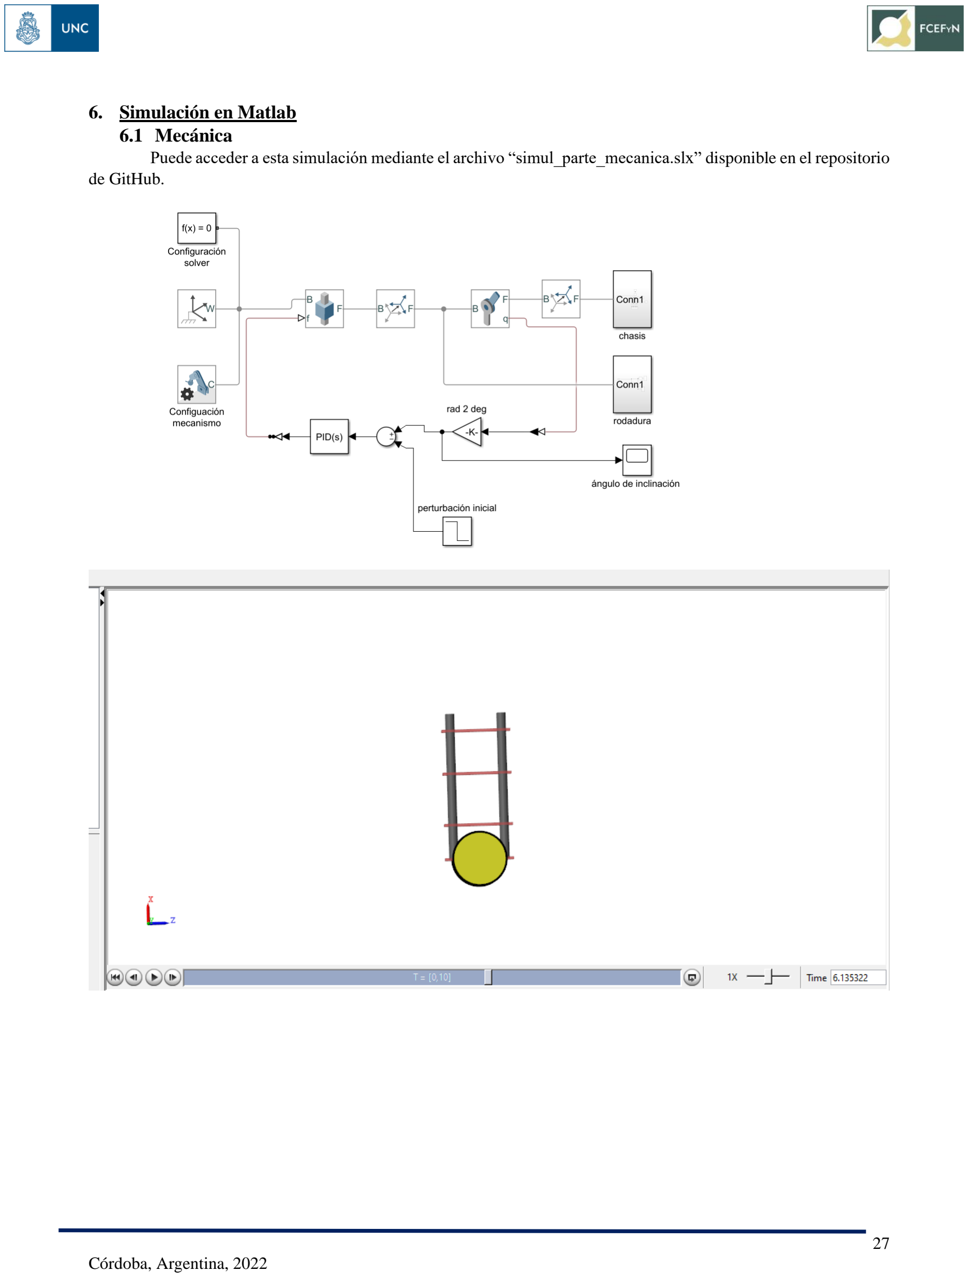
[picture p21: page 30]

### 6. Simulación en Matlab 6.1 Mecánica

Puede acceder a esta simulación mediante el archivo “simul_parte_mecanica.slx” disponible en el repositorio de GitHub.

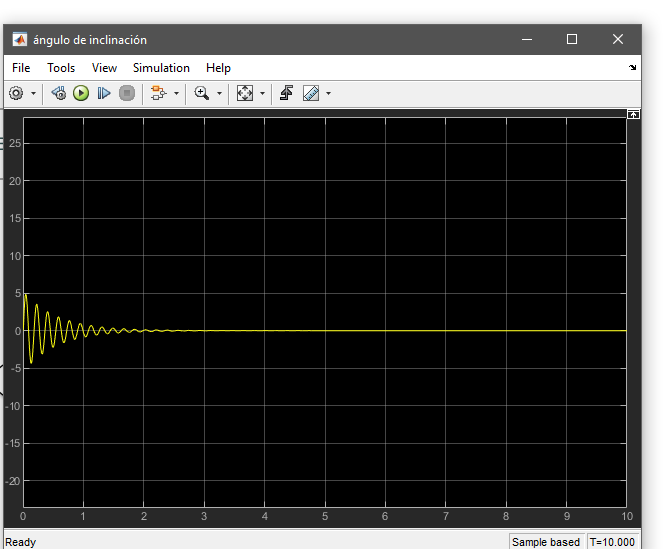
[picture p22: figure]

### 7. Conclusiones

- Respecto a lo tratado en la sección 5.2, por intuición se podría argumentar que los valores negativos de las constantes son el resultado de un sistema inestable que intenta estabilizarse con ganancias negativas. Normalmente con un sistema estable estas ganancias deberían ser positivas y no se necesitaría un factor de compensación negativo Kp. Respecto a las simulaciones y scripts realizados en Matlab, la simulación muestra la interacción mecánica de los elementos principales del chasis la estructura planteada para el sistema de control. Vemos que, en la simulación, la cual es una simplificación del sistema real implementado, las oscilaciones en el ángulo de inclinación θb desaparecen por completo en aproximadamente t = 3s, llevando al sistema a la estabilidad.
- Respecto a la validación del sistema, hemos observado que tanto en la simulación por software del sistema como en el sistema físico implementado se logró alcanzar la estabilidad, sin embargo encontramos diferencias debido a las diversas simplificaciones realizadas para la simulación, el efecto mas notorio de discrepancia entre los dos casos es que en la simulación se alcanza un estado de equilibrio total o ideal, donde luego de la respuesta transitoria el robot ya no necesita desplazarse para mantener una inclinación de 0° respecto a la normal, mientras tanto, en el sistema físico real esto no sucede, el control PID se encuentra realizando correcciones en todo momento para mantener el robot “de pie”.
- Respecto a los potenciales efectos no lineales introducidos por el filtro creado por software para el MPU6050, se observa que no han resultado críticos al nivel de impedir el control del sistema, pero presumiblemente podría ser este uno de los factores que afecta introduciendo diferencias entre el comportamiento del sistema real y el comportamiento del sistema simulado que se ha mencionado en el punto anterior.
- Tanto el robot simulado como el robot físico pueden mantener el equilibrio (aunque de forma algo errática en el caso físico) con una influencia prácticamente nula de la constante ki siempre y cuando kp y kd estén finamente ajustadas en el código fuente.

- Si bien la estabilidad del sistema puedo lograrse mediante la implementación del control PID diseñado por el método de ubicación de polos, un controlador LQR ofrecería un control óptimo sobre el sistema de entrada a través de la llamada matriz de ponderación R, sin embargo, este tema debería ser profundizado y quizás implementado a futuro.
- El material y grosor de las ruedas afectan considerablemente el funcionamiento del sistema físico, se ha comprobado como las ruedas tomadas de un viejo auto a control remoto ayudan a lograr más fácilmente la estabilidad del sistema en comparación a las utilizadas inicialmente que fueron las típicas ruedas plásticas famosas para proyectos de robótica, las cuales además de ser más angostas, no logran un agarre a la superficie tan bueno como el de las ruedas recicladas del auto a control remoto.
- Una vez encendidos todos los componentes del sistema físico, el robot (con el sistema de control) demora aproximadamente 2 segundos en comenzar a funcionar o mostrar respuesta, lo cual resulta suficiente para que robot comience a moverse sin caer, esto siempre y cuando la posición inicial en que se colocó el robot haya sido vertical, intentando aproximarse al punto de equilibrio, es decir 0°, esto no difiere sustancialmente de lo observado en la simulación. Si la posición inicial del robot no es vertical, el mismo cae, esto se debe a la incapacidad de los motores de contrarrestar el par generado por la naturaleza pendular del sistema.
- Dado que el driver controlador de los motores utilizado permite controlar cada uno de estos independientemente del otro, se pudieron realizar pruebas en las que la amplificación que se da mediante la señal PWM a cada uno de los motores difiere, esto gracias a la configuración de distintos factores de amplificación implementados por software para cada uno de ellos, lo cual resultó útil para compensar las diferencias de capacidad (respecto a las RPM) de cada motor. Si bien una mejor solución sería la implementación de un control de velocidad para cada rueda, esto no se ha realizado en este trabajo y queda como posible mejora a futuro.

### 8. Mejoras Futuras al Proyecto

Para lo que fue el alcance del curso de sistemas de control 1, los resultados de este proyecto fueron satisfactorios ya que se logró implementar y poner en funcionamiento el robot autobalenceado aplicando los aprendizajes de la materia y una gran cantidad de aprendizajes extra curriculares relacionados a la operación de los distintos componentes y la programación del sistema en general utilizando Arduino, en adición a esto la realización del proyecto ayudó a dimensionar lo complejo que pueden llegar a ser estos proyectos, en especial cuando se trabaja en equipos reducidos, la elaboración del proyecto ha consumido mucho tiempo y ha habido muchos momentos de frustración, sin embargo cada vez que se logró superar un problema, la motivación creció ayudando a seguir avanzando con la realización del proyecto.

El enfoque inicial dado para la realización de este trabajo es sumamente simplificado, ya que solo se ha implementado un control PID para controlar la inclinación del robot, sin embargo como se ha mencionado a lo largo de este informe, se podrían implementar adicionalmente controles PID para la velocidad y sincronización de giro de las ruedas, lo cual lograría un movimiento aún más estable en el sistema físico implementado, hacer esto requeriría del uso de algún tipo de encoder que permita calcular mediante software las velocidad de giro de las ruedas, hacer esto requerirá probablemente diseñar un nuevo chasis para el robot, ya que el diseño actual es sumamente compacto y prácticamente no admite la adición de más componentes. Otra mejora que se planea implementar a futuro, con un nuevo diseño es la modificación en tiempo real de las constantes del control PID, para poder realizar la configuración de estas directamente desde el hardware sin necesidad de tener conocimientos de programación, y haciendo así al robot una buena herramienta para demostrar a quienes no sepan nada del tema, como variando los parámetros se altera el comportamiento del sistema. En adición a esto se podría trabajar en mejorar el tiempo de respuesta del control bluetooth ya que la forma de control implementada actualmente es muy básica y solo permite indicar al robot cuando ir hacia delante o atrás, pero no cuando hacer giros a la izquierda o derecha, tardando además entre 2 y 3 segundos en surgir efecto el comando indicado.

### 9. Recursos

Bibliográficos

K. Ogata, 2010, “Ingeniería de Control Moderna”, 5ta Edición, Pearson Educación
T. Wescott, 2006, “Applied Control Theory for Embedded Systems”, Elsevier Inc.

Filminas Teóricas y Prácticas de la Cátedra de Sistemas de Control 1

Apuntes Personales de Cursado, Sistemas de Control 1, 2021

Web

https://fkeng.blogspot.com/2019/03/

https://sciendo.com/article/10.1515/ijame-2017-0046

http://www.ehcar.net/library/these/these028.pdf

https://aaltodoc.aalto.fi/bitstream/handle/123456789/32398/master_Silfver_Toni_2018.pdf?sequence=1&isAllowed=y (https://aaltodoc.aalto.fi/bitstream/handle/123456789/32398/master_Silfver_Toni_2018.pdf?sequence=1&isAllowed=y)

### 10. Anexo – Implementación

### 10.1 Hardware

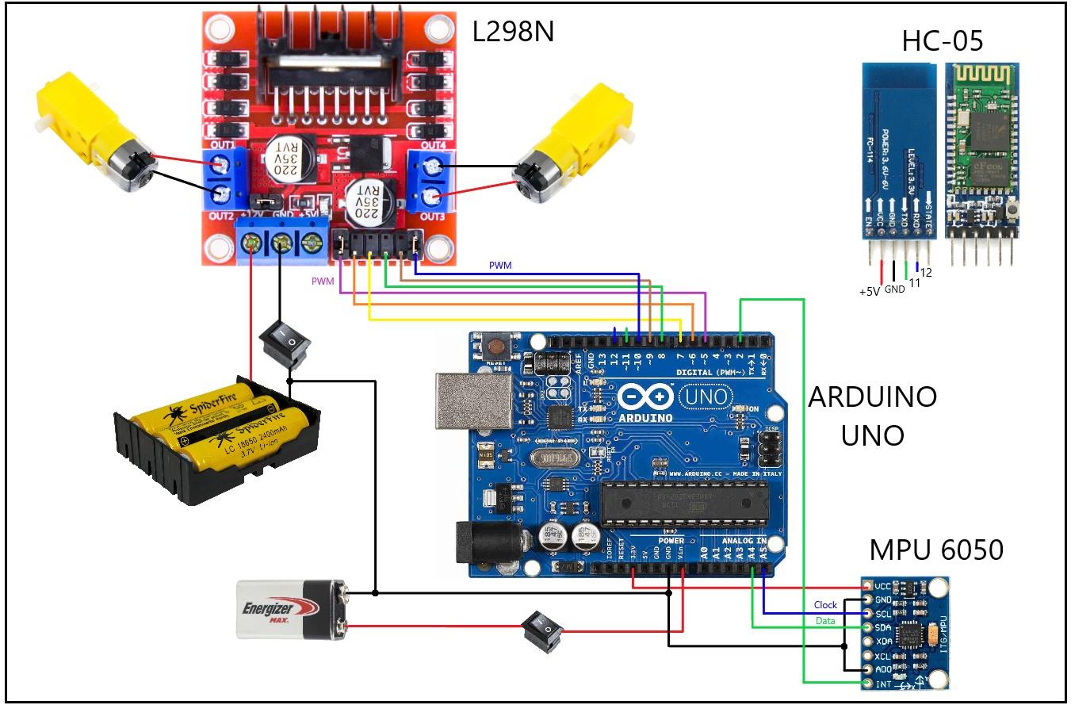
[picture p23: figure]

### 10.1.1 Driver L298N

Este módulo controlador de motores es ampliamente utilizado en proyectos de robótica y automatización que requieren el control de hasta dos motores DC como motorreductores o motores paso a paso de forma independiente. El 298N sirve para gobernar de alguna manera el rendimiento de un motor eléctrico. En el caso de este trabajo es de un motor de corriente continua. Este dispositivo nos permitirá:

- Suministrar la alimentación necesaria para el correcto funcionamiento del motor.
- Permite incluir un accionamiento manual o automático para iniciar y detener el motor.
- Da la posibilidad de cambiar fácilmente el sentido de giro y da también la opción de la regulación de la velocidad, así como regulación o limitación del par.
- Presenta protección contra sobrecargas y posibles fallas que se puedan presentar.

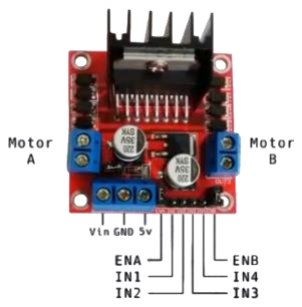
[picture p24: figure]

Figura: módulo L298N

En realidad, la denominación L298N corresponde al circuito integrado principal del módulo, el cual se encuentra montado de forma vertical sobre la placa PCB y tiene adosado un disipador pasivo de aluminio, además este circuito integrado incluye transistores de potencia para el manejo de hasta dos motores DC y se lo denomina doble puente H ya que se disponen cuatros transistores que conectados al motor forman una H, y con esta topología es posible controlar el giro del motor ya sea en sentido horario o antihorario.

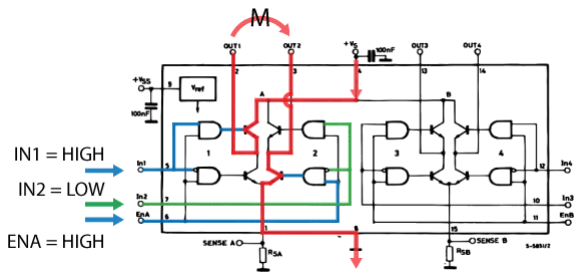
[picture p25: figure]

La conexión de los motores al módulo se realiza mediante las dos borneras ubicadas en extremos opuestos del mismo. Las salidas de los motores son controladas mediante los pines ubicados en la parte inferior derecha del módulo (3 pines izquierdos controlan el motor A y 3 pines derechos controlan el motor B), los pines ENA y ENB deben conectarse a pines PWM de Arduino, pues estos permiten habilitar los motores y realizar el control de velocidad, los mismos poseen jumpers (puentes que permiten contacto entre dos pines) que permiten que los pines ENA y ENB tengan un nivel lógico alto. Los pines IN1, IN2 y IN3, IN4 permiten establecer el sentido de giro de los motores A y B respectivamente haciendo uso de los mencionados puentes H, las tablas presentadas a continuación indican la relación entre los distintos niveles lógicos y el sentido de giro provocado por estos.

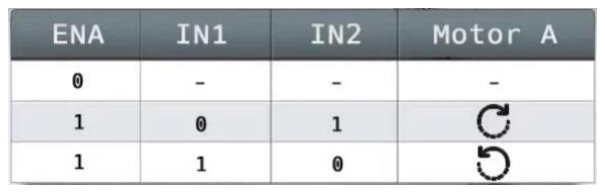
[picture p26: figure]
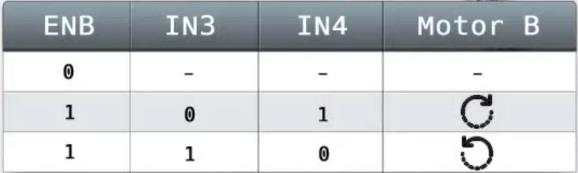
[picture p27: figure]

La alimentación del módulo se lleva a cabo utilizando los terminales Vin Y GND de la bornera, dado que estaremos trabajando con motores, y el consumo de corriente será considerable, este módulo requerirá una alimentación independiente con una tensión adecuada para el rango de funcionamiento del motor (en este caso para motorreductores de 3V a 12V) y con una provisión de corriente acorde. El terminal identificado como 5V es una salida que sirve para alimentar otros dispositivos, como por ejemplo sensores desde el mismo módulo, estos 5V son generados a partir de la tensión de alimentación que pasa por un circuito integrado regulador de tensión (LM7805) el cual no puede recibir tensiones mayores a los 12V, es decir que en caso de utilizar una alimentación con tensión superior a este valor sería necesario quitar el jumper del regulador para deshabilitarlo y así eliminar el riesgo de quemarlo, en nuestro caso la tensión de trabajo es inferior a los 12V y esto no supone ningun problema.

Para controlar la velocidad de los motores se debe controlar también el voltaje de entrada del motor y para lograr esto el módulo utiliza la modulación por ancho de pulsos (PWM). PWM es una técnica que permite ajustar el valor promedio de la tensión suministrada al motor utilizando secuencias de on-off. La tensión promedio depende del Duty Cycle y mientras mayor sea este, mayor tensión aplicada a los terminales de los motores, y a su vez mayor velocidad.

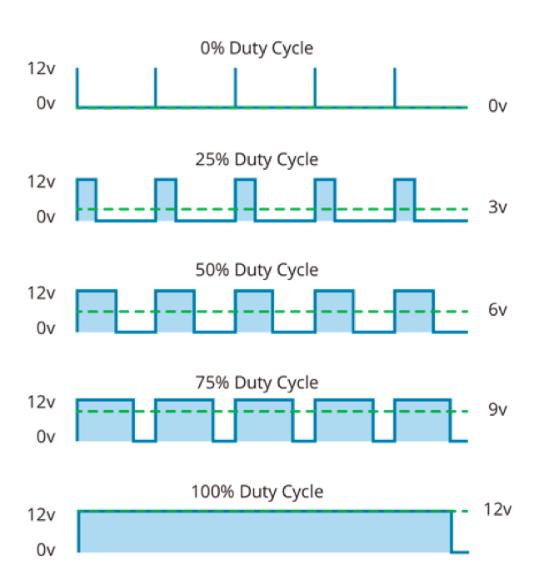
[picture p28: figure]

### 10.1.2 Motorreductores

Como ya se ha visto, para el proyecto estaremos utilizando motorreductores, es decir motores DC con escobillas que incluyen una caja reductora. La alimentación del motor se aplica mediante dos terminales conectados a las escobillas que hacen contacto con el rotor (parte giratoria). La circulación de corriente por las bobinas del rotor genera un campo magnético que interactúa con el de los imanes permanentes, generándose una fuerza que permite la rotación del eje conectado al rotor.

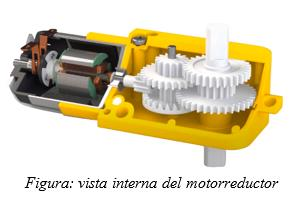
[picture p29: figure]
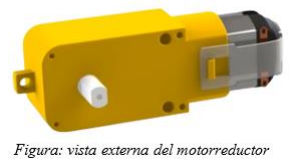
[picture p30: figure]

La caja reductora encierra a los engranajes que generan una reducción de la velocidad dada por la relación de transmisión o “gear ratio” y como consecuencia de dicha reducción se genera un aumento proporcional del torque en el eje de salida.

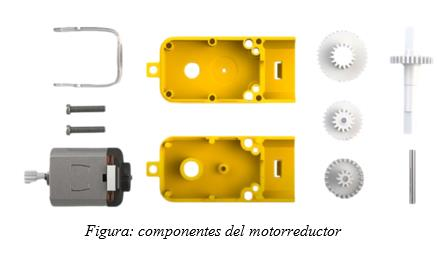
[picture p31: figure]
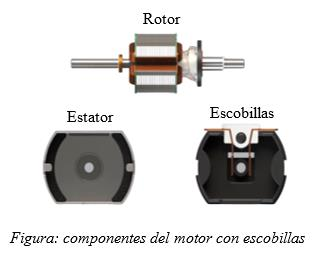
[picture p32: figure]

Respecto de la forma de uso de estos motores podemos aclarar que al igual que cualquier motor DC, requiere un controlador de corriente para controlarlo con un micro (en nuestro caso Arduino), esto es porque como mínimo este motor (y cualquier otro) consume más corriente de la que puede proveer el pin.

Estos motores de origen chino son de uso frecuente en proyectos de robótica y son genéricos, no incluyen ningun tipo de codificador incorporado, control de velocidad o retroalimentación posicional, básicamente su funcionamiento se resume en “tensión entra, rotación sale”. Los vendedores en tiendas online de estos motores ofrecen versiones con distintas relaciones de reducción, sin embargo en tamaño y peso todos son idénticos a simple vista, lo que dificulta saber si las especificaciones presentadas por el vendedor se corresponden realmente con el modelo pedido, según se ha investigado, en muchos casos los vendedores ofrecen un modelo con una determinada relación de reducción, y a la hora de recibir el producto se trata de una relación de reducción distinta, este tipo de situación se desprende del hecho de la poca información disponible sobre estos motores, de hecho, ni siquiera es posible saber con total certeza quien es el fabricante.

A causa de esto se ha realizado una ardua labor de búsqueda de las hojas de datos de estos motores hasta que eventualmente, mediante la contrastación de los datos en las hojas de datos halladas y las mediciones físicas realizadas en los ensayos con nuestros propios modelos (mediciones de corriente sin carga, corriente con carga máxima, RPM a 6V, peso y dimensione físicas) y finalmente hemos dado con el que creemos puede ser modelo de nuestros motores. Se trata del modelo TGP01DA130 del fabricante TTMOTOR, más concretamente del 12215-48 (porque la relación de reducción es 1:48), este producto es el motor reductor visto en las imágenes anteriores, el cual incluye la caja reductora. Sin embargo, también hemos dado con el modelo de motor con escobillas que implementa este motor reductor, tratándose en este caso del TFE-130RA-12215 del fabricante Pololu Robotics and Electronics.

Habiendo realizado esta serie de aclaraciones el lector puede hallar las hojas de datos de los modelos mencionados en el anexo siendo avisado el lector de que estos parámetros de motores usados para el modelado matemático corresponden a modelos reales de motores, y probablemente (pero no necesariamente) corresponden o se asemejan a los de los motores utilizados en esta práctica. También estarán disponible en el anexo algunas imágenes que documentan y explican brevemente en que consistieron los ensayos realizados a los motores para realizar el contraste de los resultados obtenidos con las especificaciones de las hojas de datos.

### 10.1.3 Acelerómetro y Giroscopio MPU-6050

El sensor MPU-6050 es un IMU (Unidad de Medición Inercial) permite obtener aceleración lineal y velocidad de rotación sobre tres ejes, y en base a estos datos podemos obtener el angulo de inclinación del robot.

Internameinte el el módulo IMU MPU-6500 esta formado por un acelerómetro de 3 ejes, giroscopio de 3 ejes y un DPM (Procesador de Movimiento Digital) el cual toma los datos de los sensores y aplica un procesamiento para enviar información preprocesada y quitarle así carga de cálculo al microcontrolador de la placa Arduino. El dispositivo opera con una tensión de 3.3 V pero tambien incorpora un regulador que permite la alementación directa a 5 V desde Arduino.

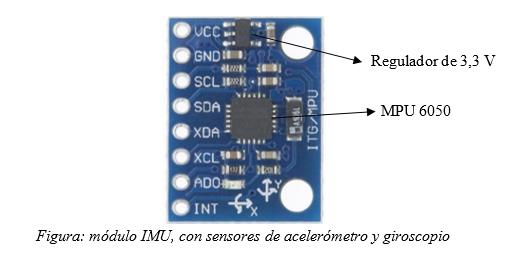
[picture p33: figure]

El acelerómetro mide la aceleración inercial (cambio de velocidad en el tiempo). Los acelerómetros internamente tienen un MEMS(MicroElectroMechanical Systems) que de forma similar a un sistema masa resorte permite medir la aceleración lineal.

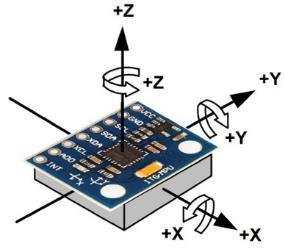
[picture p34: figure]

La aceleración es la variación de la velocidad por unidad de tiempo es decir la razón de cambio en la velocidad respecto al tiempo: a =

dv
dt

Así mismo la segunda ley de Newton indica que en un cuerpo con masa constante, la aceleración del cuerpo es proporcional a la fuerza que actúa sobre él mismo: a =

F
m

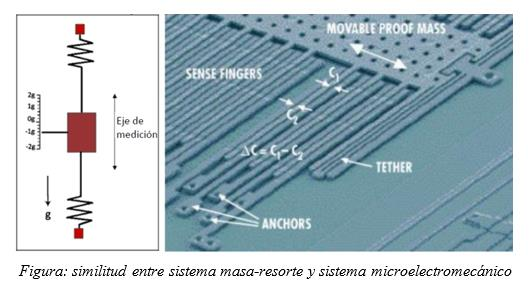
[picture p35: figure]

Con un acelerómetro podemos medir esta aceleración, teniendo en cuenta que a pesar que no exista movimiento, siempre el acelerómetro estará sensando la aceleración de la gravedad.

Con el acelerómetro podemos hacer mediciones indirectas, por ejemplo, si integramos la aceleración en el tiempo obtendremos la velocidad y si la integramos nuevamente obtendremos el desplazamiento, necesitando en ambos casos la velocidad y la posición inicial respectivamente.

Obtención de ángulos mediante el acelerómetro

La gravedad de la Tierra es perpendicular al suelo. Como es lógico, la IMU detecta la aceleración de la gravedad terrestre y gracias a ello se pueden usar las lecturas del acelerómetro para saber cuál es el ángulo de inclinación respecto al eje X o eje Y. Supongamos la IMU paralela con el suelo. Entonces, el eje Z marcará 9.8, y los otros dos ejes marcarán 0. Ahora girando 90 grados por el eje Y, es el eje X el que queda perpendicular al suelo, por lo tanto marcará la aceleración de la gravedad.

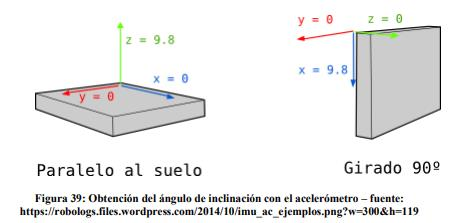
[picture p36: figure]

Al saber que la gravedad es 9.8 m/s², y las medidas que dan los tres ejes del acelerómetro, por trigonometría es posible calcular el ángulo de inclinación de la IMU mediante las siguientes fórmulas:

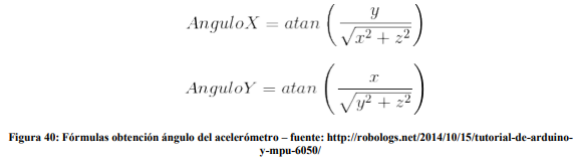
[picture p37: figure]

Funcionamiento del Giroscopio

El giroscopio mide la velocidad angular alrededor de un eje (grados/s) (velocidad de giro o momento angular). La velocidad angular es la tasa de cambio del desplazamiento angular por unidad de tiempo, es decir que tan rápido gira un cuerpo alrededor de su eje:

Los giroscopios utilizan un MEMS (MicroElectroMechanical Systems) para medir la velocidad angular usando el efecto Coriolis. Con un giroscopio podemos medir la velocidad angular, y si se integra la velocidad angular con respecto al tiempo se obtiene el desplazamiento angular (posición angular si se sabe dónde se inició el giro).

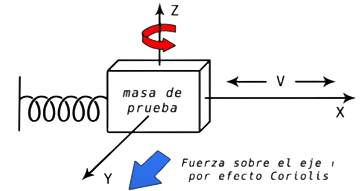
[picture p38: figure]
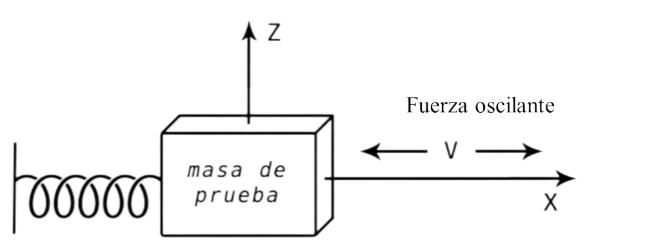
[picture p39: figure]

Si sobre el eje z se aplica una fuerza de rotación, por efecto Coriolis aparecerá una fuerza sobre el eje y, y dado que se tratará de una aceleración lineal es posible medirla de la misma forma que en el caso del acelerómetro, es decir en este caso la fuerza en el eje y será proporcional a la velocidad de rotación sobre el eje z. Este razonamiento es similar para los 3 ejes.

Para la implementación en el robot, lo que nos interesará será obtener el ángulo de inclinación del robot respecto de una posición inicial.

Si se sabe el ángulo inicial de la IMU, se puede ir sumando el valor que marca el giroscopio para saber el nuevo ángulo a cada momento. Supongamos que iniciamos la IMU a 0º. Si el giroscopio realiza una medida cada segundo, y marca 3 en el eje X, tendremos el ángulo con esta sencilla fórmula:

Consideraciones y Limitaciones del MPU 6050

Existen ciertas limitaciones para los sensores de acelerómetro y giroscopio que integra el MPU6050. Si bien con el acelerómetro podemos medir cualquier ángulo, los valores que detecta por sí mismo presentan problemas de ruido y efecto de jitter, mientras que los del giroscopio tienden a ser bastante precisos inicialmente, pero con el tiempo comienzan a presentar desviaciones debidas a la acumulación de errores que se propaga al realizar el cálculo del ángulo, en ambos casos esto puede afectar negativamente a la capacidad de nuestro robot para mantenerse equilibrado en posición vertical. Frente a esta dificultad tenemos dos opciones para evitar estas situaciones:

- Diseñar y utilizar un algoritmo de filtro complementario que estime el ángulo de inclinación en base al tratamiento matemático de los datos obtenidos tanto por el giroscopio como por el acelerómetro.
- Utilizar directamente la fusión de datos que permite el procesador de movimiento digital (DMP) incluido en el MPU6050. Si bien no hay información publicada acerca del algoritmo utilizado por el chip DMP para realizar los cálculos que fusionan las mediciones del giroscopio y del acelerómetro, el mismo sigue siendo útil porque presumiblemente tiene un algoritmo de fusión bastante bueno y porque los cálculos del DMP se realizan en el chip MPU-6050, lo que libera la potencia del procesador.

Para nuestro robot hemos decidido optar por la segunda opción, ya que desarrollar un algoritmo de filtro complementario es una tarea que demandaría tiempo extra y en base a la investigación realizada en blogs, foros y otros trabajos académicos, tenemos la certeza de que utilizar directamente el DPM proporciona mejores resultados que el uso de un filtro complementario.

Recursos externos de posible interés para el lector:

- Video comparativo de filtro complementario VS chip DPM: https://www.youtube.com/watch?v=2t-5CCyPJ74&ab_channel=geekmomprojects (https://www.youtube.com/watch?v=2t-5CCyPJ74&ab_channel=geekmomprojects)
- Enlace de descarga de documento hallado en la web, donde los autores hacen uso de un filtro complementario y muestran algunas conclusiones interesantes respecto del mismo (gráficos presentados en este documento adjuntos en el anexo): https://www.researchgate.net/publication/324029194_A_new_Design_and_Control_of_a_Two-Wheel_Self-_Balancing_Robot_using_the_Arduino_Microcontroller (https://www.researchgate.net/publication/324029194_A_new_Design_and_Control_of_a_Two-Wheel_Self-_Balancing_Robot_using_the_Arduino_Microcontroller)
- https://www.youtube.com/watch?v=qmd6CVrlHOM&t=1s&ab_channel=geekmomprojects

### 10.1.4 Alimentación

Los motores utilizados trabajan en el rango de 3 a 12 volts, por ello ha optado por utilizar tres baterías de iones de litio recargables de 3.7 V y 2200 mAh de autonomía, de forma que dispondremos de aproximadamente 11.1 V para la alimentación de los motores. Si bien este valor de tensión es excesivo para el tipo de motores utilizados el mismo será reducido vía software modificando el ciclo de trabajo de la señal PWM.

Por otra parte, se ha decidido alimentar la placa Arduino UNO y los demás módulos utilizados (MPU6050 y modulo bluetooth HC-05) con una batería de 9V.

### 10.1.5 Módulo Bluethoot HC-05

Este módulo es el encargado de establecer la comunicación bluetooth para controlar el robot, el mismo admite múltiples configuraciones vía software ingresando al modo de comandos AT, entre las configuraciones más útiles se encuentran el nombre del dispositivo, código para para emparejamiento, baud rate, modo, etc. La configuración de mayor relevancia es el modo, pudiendo ser este maestro o esclavo, para este proyecto el HC-05 será utilizado en modo esclavo ya que será comandado por una app para dispositivos Android.

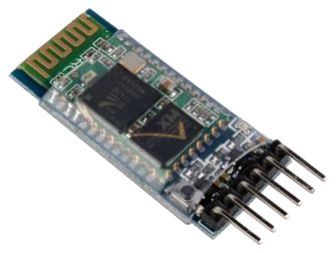
[picture p40: figure]

- Conexiones y configuración de comandos AT para el HC-05: https://www.youtube.com/watch?v=lTvYbnr6aBo&list=WL&index=84&t=483s&ab_channel=INVOOTE CHNICAGLOBALPVT.LTD. (https://www.youtube.com/watch?v=lTvYbnr6aBo&list=WL&index=84&t=483s&ab_channel=INVOOTECHNICAGLOBALPVT.LTD)
- | Resumen | de | comandos | AT: | https://s3-sa-east-1.amazonaws.com/robocore-lojavirtual/709/HC-
05_ATCommandSet.pdf (https://s3-sa-east-1.amazonaws.com/robocore-lojavirtual/709/HC-05_ATCommandSet.pdf)

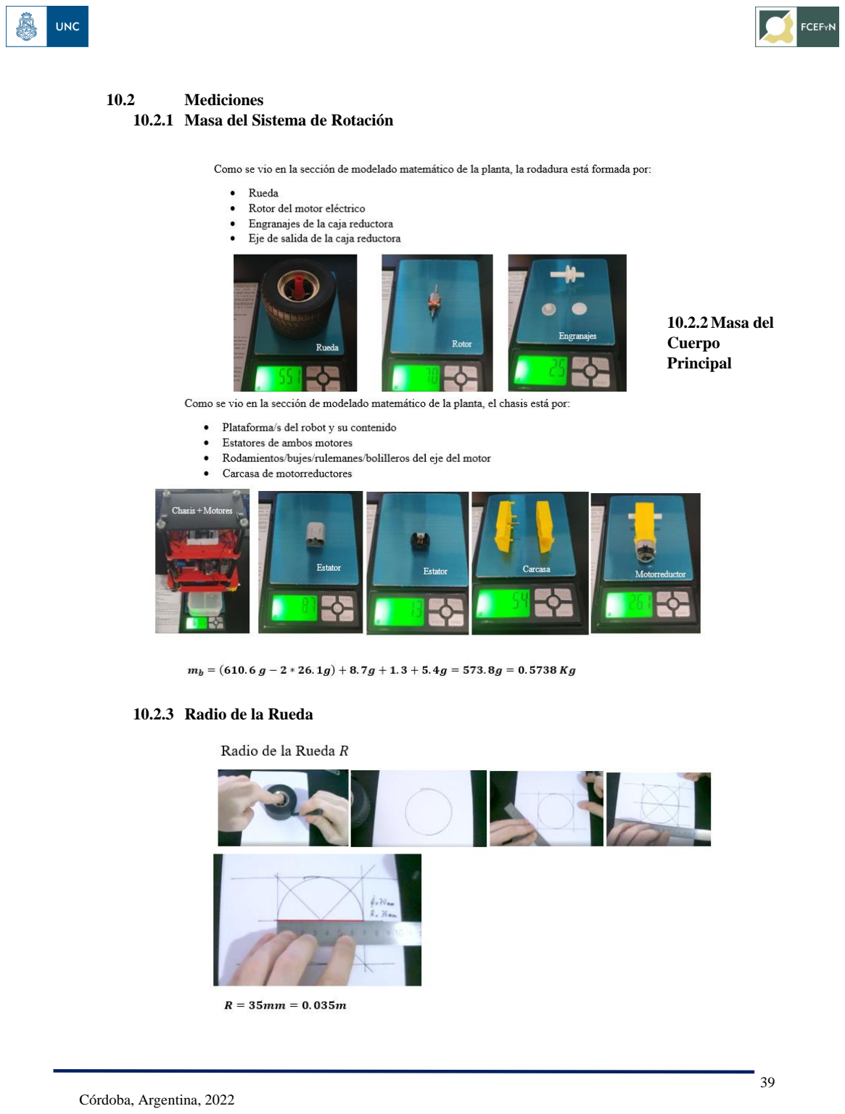
[picture p41: page 42]

### 10.2 Mediciones 10.2.1 Masa del Sistema de Rotación

### 10.2.2 Masa del

Cuerpo
Principal

### 10.2.3 Radio de la Rueda

### 10.2.4 Longitud del Centro de la Rueda al Centro de Masa del Chasis

En primer lugar, se ha recurrido al modelo CAD aproximado del robot realizado mediante el software Fusion360 de AutoDesk, este permite visualizar la ubicación del centro de masas. El modelo realizado contiene los componentes principales (más pesados) del robot, sin embargo, esto se hace solo a nivel estimativo y principalmente visual, ya que además esta actividad nos permite introducirnos a la utilización de este software desconocido hasta el momento.

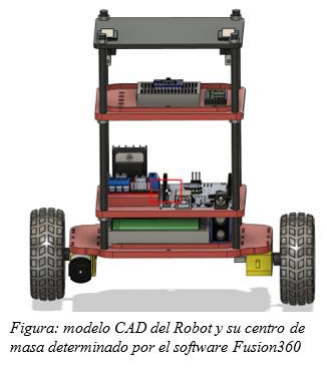
[picture p42: figure]

Para hallar el centro de masa del chasis de una forma más confiable y rigurosa (pero aun aproximada) que la descripta anteriormente utilizaremos un método experimental utilizando el cuerpo principal o chasis del robot.

Recordemos primero algunos conceptos básicos, el centro de masa y el centro de gravedad de un cuerpo es el mismo punto cuando el cuerpo se encuentra en un campo gravitatorio uniforme (magnitud y dirección constante), a efectos prácticos esta coincidencia se cumple con precisión aceptable para casi todos los cuerpos sobre la superficie terrestre puesto que la disminución de intensidad gravitatoria es muy pequeña en toda la extensión de los cuerpos. Además, el centro geométrico de un cuerpo coincide con el centro de masa si el objeto es homogéneo o cuando se presentan ciertas propiedades como la simetría del cuerpo.

El método consistirá en suspender el chasis desde múltiples puntos de este hacia un pivot fijo mediante un hilo fino o tanza de forma que el objeto pueda moverse libremente. Se toman fotografías del robot pendiendo de distintos puntos, todas las fotografías estarán tomadas desde la misma posición, con un cuadro fijo que asegure los mismos ángulos y las mismas condiciones de luz en todas las fotografías. Una vez que se dispongan de varias fotografías (con dos es suficiente para hallar el CM) se recurre a software de diseño grafico y se siguen los siguientes pasos:

- Para ambas fotografías se prolongan las líneas de la tanza para que sea fácilmente visible.
- Se toma una de las fotografías de referencia.
- Se manipula la otra fotografía para que queden alineadas lo mejor posible con la fotografía de referencia y se la superpone a esta última.
- Se identifica el punto de intersección entre las líneas, el cual será el centro de masa.

Antes de seguir estos pasos notemos que el robot presenta un nivel aceptable de simetría en el plano zy (ver figura), entonces vamos a dividirlo imaginariamente mediante una especie de corte transversal en dos mitades iguales y asumiremos que el centro de masa se encuentra en el plano zy que contiene a la línea divisoria de la figura

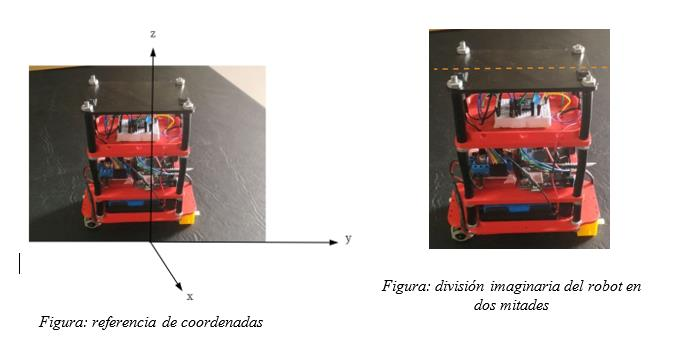
[picture p43: figure]

A continuación, se realiza el procedimiento descripto:

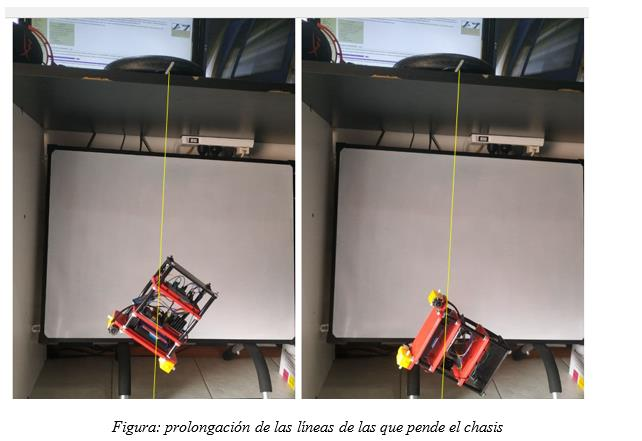
[picture p44: figure]

Resultado de aplicar transparencia a una de las fotografías y luego superponerla con la fotografía de referencia:

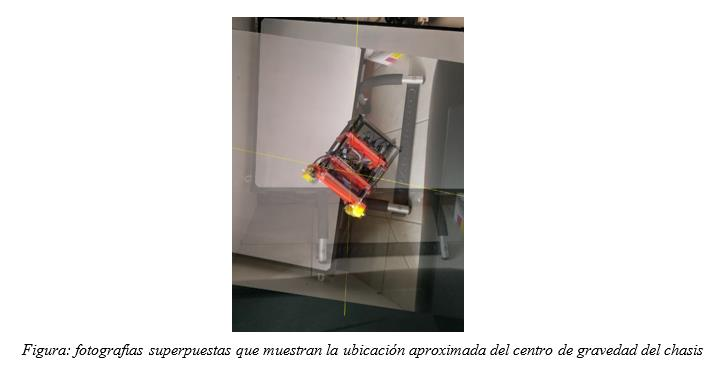
[picture p45: figure]

Podemos comprobar de esta forma que el centro de masa estimado mediante los dos métodos es a grandes rasgos muy similar y para los fines de este trabajo resulta suficiente. Tras realizar una simple medición con una regla de 0.5 mm de graduación se ha comprobado que la distancia desde el eje de salida de la caja reductora (o centro de la rueda) hasta el centro de masa es aproximadamente l = 7cm = 0. 07m

### 10.2.5 Inercia Mecánica del Chasis Jb

Para estimar este parámetro analizaremos el momento inercial de los elementos que lo componen considerándolos objetos rectangulares con masa distribuida uniformemente y los combinaremos utilizando el teorema de los ejes paralelos, también llamado teorema de Steiner.

Veamos primero la masa y dimensiones de los elementos que estaremos considerando:

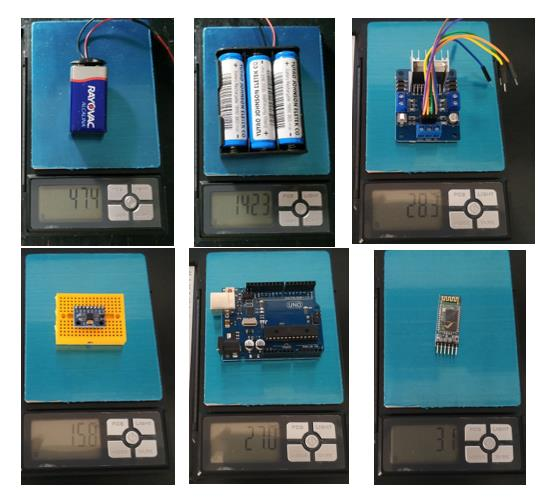
[picture p46: figure]
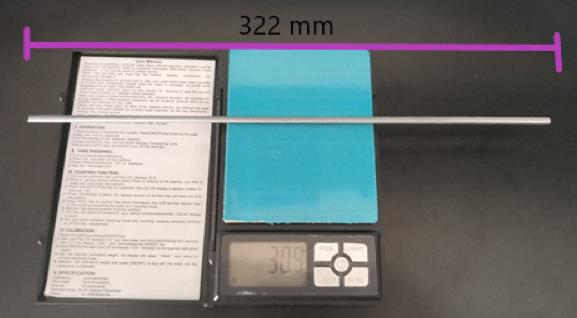
[picture p47: figure]

La varilla metálica fue pesada luego de construir el robot con lo que había sobrado, entonces considerando que la longitud de las varillas utilizadas en el robot es de 170mm, su peso es de aproximadamente 16. 3g.

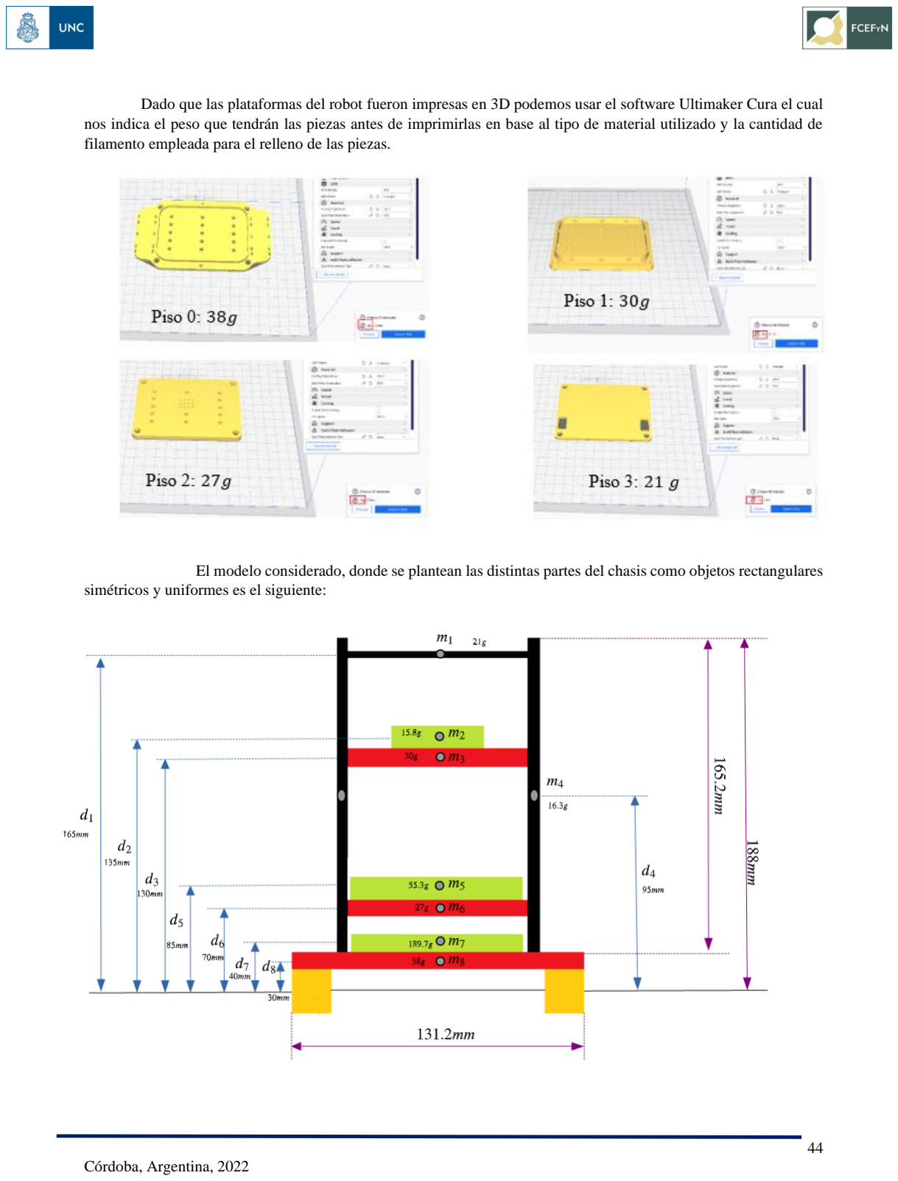
[picture p48: page 47]

Dado que las plataformas del robot fueron impresas en 3D podemos usar el software Ultimaker Cura el cual nos indica el peso que tendrán las piezas antes de imprimirlas en base al tipo de material utilizado y la cantidad de filamento empleada para el relleno de las piezas.

El modelo considerado, donde se plantean las distintas partes del chasis como objetos rectangulares simétricos y uniformes es el siguiente:

En este modelo hemos agrupado los componentes de la siguiente manera:

- El objeto rectangular de la base considera la masa de las baterías de iones de litio y de la batería de 9 V.
- El objeto rectangular en el primer piso considera la masa de la placa Arduino, el controlador de motores L298N y el módulo bluetooth HC-05.
- El objeto rectangular en el segundo piso considera la masa de una protoboard de 170 puntos y del sensor MPU6050.

A partir de aquí el cálculo de Jb lo realizaremos con ayuda de Matlab aplicando el teorema de Steiner y basándonos en la figura anterior y en la figura. El código utilizado estará disponible como anexo.

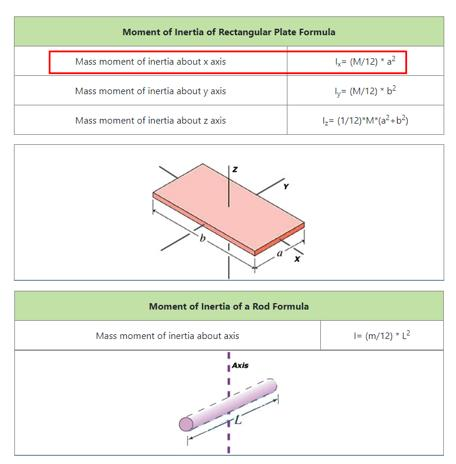
[picture p49: figure]

A continuación, se resumen las dimensiones y masas de las hipotéticas geometrías rectangulares que se utilizarán en Matlab:

Elementos | Masa | Dimensiones
Piso 3 | m1 = 21g | 110 * 75.5 mm
Objeto piso 2 | m2 = 15.8g | 47 * 34 mm
Piso 2 | m3 = 30g | 110 * 75.5 mm
Varillas | m4 = 16.3g | 165.2 mm
Objeto piso 1 | m5 = 55.3g | 100 * 65mm
Piso 1 | m6 = 27g | 110 * 75.5mm
Objeto base | m7 = 189.7g | 110 * 75.5 mm
Base | m8 = 38g | 150 * 85 mm

Programa realizado en Matlab:

Al ejecutar el programa obtenemos Jb ≅ 0. 0024 Kg m2 close all, clear all; clc;
%Con este programa calcularemos el momento de inercia para el chasis %utilizando el teorema de los ejes paralelos o teorema de Stainer.
% | Utilizaremos | las | fórmulas | de | momento | de | inercia | para | placas
rectangulares
% y para varillas que se detallan en el informe en la sección de mediciones

% Masas de los objetos considerados [Kg]
m1 = 0.021;
m2 = 0.0158;
m3 = 0.03;
m4 = 0.0163;
m5 = 0.0553;
m6 = 0.027;
m7 = 0.1897;
m8 = 0.038;
% Distancias de los objetos al eje de rotación del chasis [m] d1 = 0.165;
d2 = 0.135;
d3 = 0.130;
d4 = 0.095;
d5 = 0.085;
d6 = 0.07;
d7 = 0.04;
d8 = 0.03;
%Lado a de las placas rectangulares [m] a1 = 0.0755;
a2 = 0.034;
a3 = 0.0755;
a5 = 0.065;
a6 = 0.0755;
a7 = 0.0755;
a8 = 0.085;
%Longitud de la varilla [m]
l = 0.1652;
%Aplicamos el teorema de los ejes paralelos: | Ji = Jcm + mi*li^2 [Kg m2]
Jb | = | (m1/12)*(a1^2)+ | m1*(d1^2) | + | (m2/12)*(a2^2)+ | m2*(d2^2) | +
(m3/12)*(a3^2)+ | m3*(d3^2) | + | (m5/12)*(a5^2)+ | m5*(d5^2) | + | (m6/12)*(a6^2)+
m6*(d6^2) + (m7/12)*(a7^2)+ m7*(d7^2) + (m8/12)*(a8^2)+ m8*(d8^2) + (m4/12)*l^2

### 10.2.6 Inercia Mecánica de la Rodadura Jw

Para estimar este parámetro consideraremos únicamente la rueda y el rotor, ignorando los efectos de la caja reductora. Calcularemos los momentos inerciales por separado asumiendo distribución uniforme de las respectivas masas y luego los sumaremos.

Para estimar el momento inercial tanto de las ruedas como de los rotores consideraremos a estos elementos como cilindros sólidos:

Jrueda =

mrueda
2

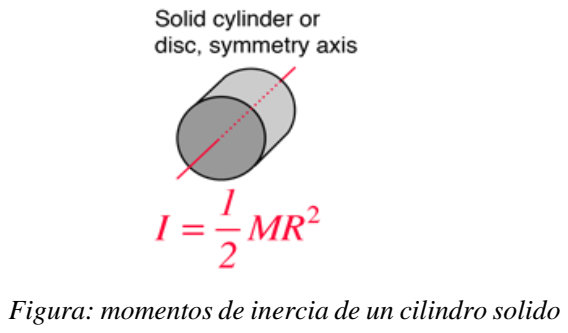
[picture p50: figure]

R

2
rueda = 0.5 ∗ 0.0551 Kg ∗ (0.035m)

2 = 0.000034 Kg m²

Jrotor =

mrotor
2

R

2
rotor = 0.5 ∗ 0.007 Kg ∗ (0.005m)

2 = 8.75x10⁻⁸ Kg m²

Jw = Jrueda + Jrotor = 0.0000515 Kg m²

Figura: momentos de inercia de un cilindro solido

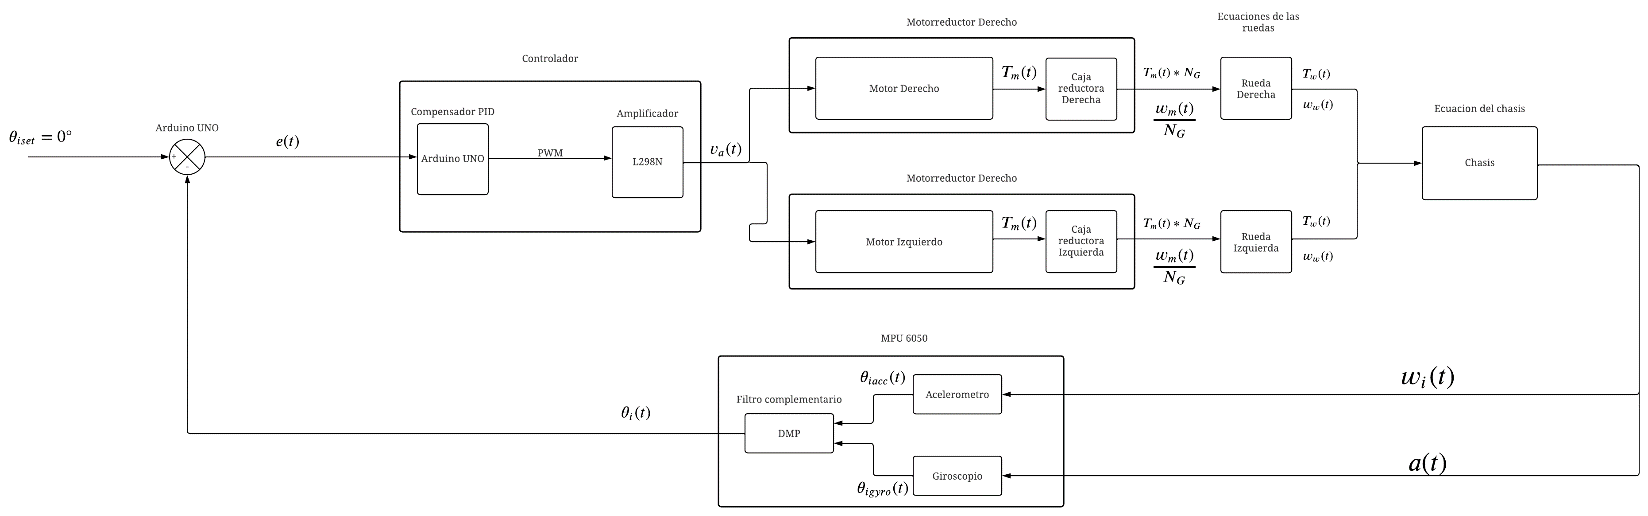
[picture p51: figure]
